mzy410104-lgtm/auto_car/TAXI_TT02_ARCHITECTURE_FINAL_CLEANUP_PROMPT.txt

Precisely clean up the provided engineering diagram. Preserve every box, word, color, font, and all other connections. Make ONLY these two local line corrections. Reference image dimensions are 1672 x 941; coordinates below are approximate guides.

1. In the left panel, REMOVE the entire obsolete blue stub coming out of the TOP of "SHARP GP2Y0A21YK0F ×2": the segment rises from approximately (363,670) to (363,643), then runs right to approximately (430,643). Erase that whole unused L-shaped wire and its tiny upward tail. Keep the existing downward arrow from the BOTTOM of SHARP into "Adaptation des entrées analogiques". Keep the existing blue wire from the RIGHT edge of the adaptation block (approximately 457,762), going right and then UP to the NUCLEO bottom edge at approximately (473,612). Put the label "ADC" beside this retained adaptation-output vertical wire. Final SHARP path must have exactly one chain: sensor -> input adaptation -> STM32, with NO outgoing wire from the TOP of SHARP and no unconnected blue stub.

2. In the right power panel, REMOVE ONLY the redundant OUTER LEFT red wire linking the LEFT edge of "Entrée batterie du TBLE-04S" to the LEFT edge of "BEC du TBLE-04S". It starts around (1154,411), goes left to (1134,411), down to (1134,561) and right to (1148,561). Erase that entire outer-left U-shaped red route and its arrowhead at BEC. KEEP the distinct existing red vertical branch from the RIGHT side of the ESC input block down into the TOP of BEC, around x=1283 from y=436 to y=545. KEEP the separate arrow from ESC input down to "Sortie moteur". Final connection: ESC input block has exactly two outgoing red arrows, one to motor output and one to BEC. There must be no link from motor output to BEC.

Do not redraw anything else. No new wording, boxes, sensors, wires, arrows or power connections. The intended final architecture and remaining labels are already correct. Erase obsolete wires cleanly to the existing white background without blur, artifacts or traces. Retain the full image and its legibility.
