mzy410104-lgtm/auto_car/data/raw/README.md

# Large Raw Data

This directory is reserved for large local files such as lidar recordings and long videos. Git tracks only this README by default. No new recordings have been saved here.

Once actual team-shared storage is in use, record the original filename, acquisition conditions, size, checksum information and accessible location in tests/records. Enter the actual sharing URL and permissions; do not commit access tokens.
