mzy410104-lgtm/auto_car/sources/architecture/ARCHITECTURE_ORIGINAL_2026-09-08.jpg

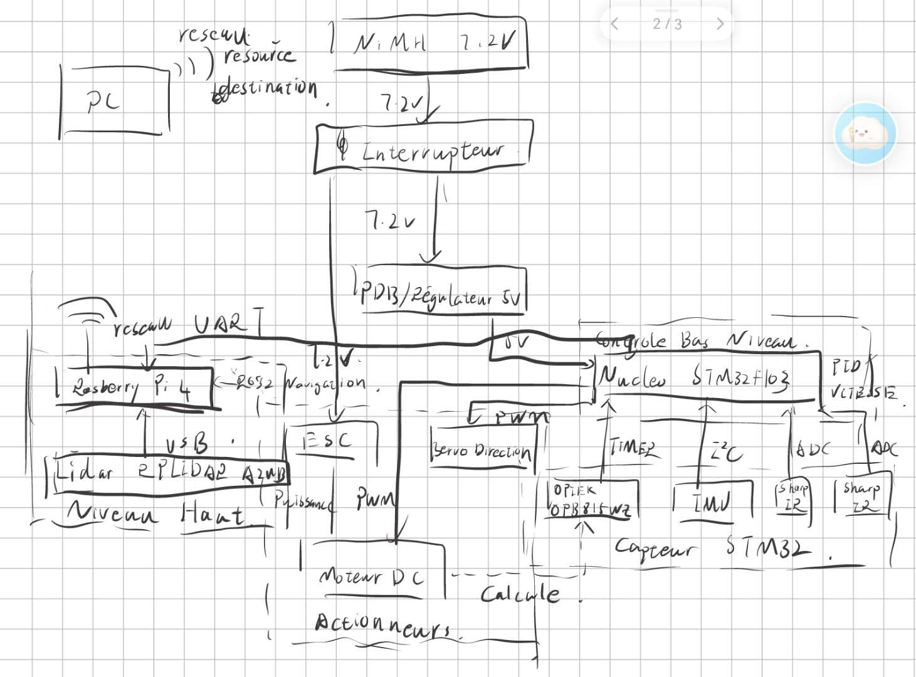
sources/architecture/ARCHITECTURE_ORIGINAL_2026-09-08.jpg
