mzy410104-lgtm/auto_car/TAXI_TT02_ARCHITECTURE_COMPLETED.png

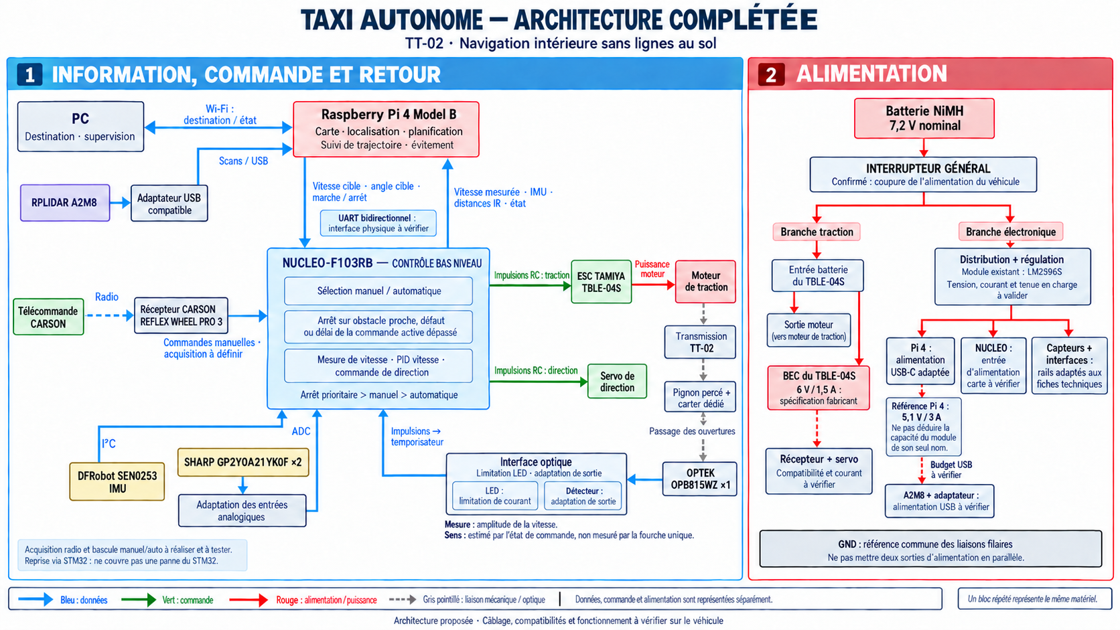
TAXI_TT02_ARCHITECTURE_COMPLETED.png
