mzy410104-lgtm/auto_car/EXISTING_HARDWARE_INVENTORY_EN.md

# Autonomous Taxi: Existing Hardware Inventory

Record date: 2026-09-08. Basis: the user confirmed, “This is the hardware we already have,” and has provided thirteen photographs so far. Figures 1 through 11 show the complete vehicle, components, and labels; Figure 12 is the chassis illustration on the packaging; Figure 13 shows the handheld transmitter. The correspondence between figure numbers and original images is listed at the end. The user separately confirmed that there are 2 SHARP sensors, that the vehicle's ESC is a TAMIYA TBLE-04S, that the Gravity sensor board is a DFRobot SEN0253, and that the adjustable power board is called “Arduino LM2596S.” The user also stated that the propulsion battery brand is PTH08, its chemistry is NiMH, and its nominal voltage is 7.2V. The user previously selected the TT-02; the available photographs do not show the complete chassis kit part number.

This record confirms that items are present and records legible markings. Power-up, communication, sensor outputs, driving, and navigation functions have not yet been checked. Neither historical project documents nor model recommendations from the previous proposal automatically identify the physical items in the photographs.

**Camera-method update (2026-09-22): the user retained the decision not to purchase a stereo camera and adopted visual map-region recognition using an onboard monocular camera.** The camera supplies a validated place or map-region constraint; lidar map matching, wheel-speed feedback and IMU information supply the continuous planar pose. Existing availability, exact camera model, interface, field of view and mounting arrangement have not been provided, so camera ownership and procurement status remain to be checked. Do not record a specific camera as selected until its marking or purchasing decision is available.

**Existing accessories update (2026-09-08): the user confirmed, “We have a bootable SD card, enough data cables, and a handheld transmitter.”** These three items are removed from the list of items whose presence needs confirmation and from default additional purchases. Figure 13 has legible CARSON, REFLEX WHEEL, PRO, and numeral 3 markings; the item is recorded as 1 CARSON REFLEX WHEEL PRO 3 series handheld transmitter. The series name does not establish its complete product number, actual pairing with the receiver, or behavior when the radio link is lost. The system card is recorded as bootable on the basis of the user's confirmation; its capacity, operating system version, and navigation software operating status are not yet verified. Having enough data cables does not establish that the lidar USB adapter or communication functions have been verified.

The packaging illustration in Figure 12 is reference material. Its depicted models and “NOT INCLUDED” labels cannot replace the record of the actual equipment on the current vehicle.

## Assessment of Support for the Project

**Assessment on 2026-09-08: the existing hardware covers the main computing, sensing, and actuation components and can serve as the development basis for an indoor, low-speed navigation prototype without floor markings. It is not yet established that the existing parts alone can reliably meet every objective.** This is an engineering assessment based on the confirmed hardware and manufacturer specifications; functional testing, performance testing, and acceptance of this particular vehicle have not been completed.

| Project function | Existing hardware basis | Work still required |
|---|---|---|
| Mapping and localization on a map | A2M8 and Pi4 for mapping and lidar map matching; monocular camera for validated place/map-region constraints; wheel-speed feedback and SEN0253 for motion information | Camera availability and model; real images with map-region labels; held-out-run visual validation; valid lidar scans; coordinate transforms and stable `(x, y, yaw)` localization; neither the IMU nor one image class directly provides XY coordinates |
| Fixed-pickup request and route planning | Location-specific QR codes and phone web page; Pi4 request service and station-pose configuration | Network path from phone to vehicle; pickup-identifier handling; mapped stopping pose and arrival heading for each pickup point; routes that accommodate vehicle dimensions, steering constraints and actual space |
| Path following | NUCLEO-F103RB, TBLE-04S, existing motor and servo | The user confirmed that the speed-sensing assembly is absent; it must be purchased and mechanically installed, followed by verification of speed feedback, speed and steering calibration, smooth low-speed operation, braking, and reverse behavior |
| Real-time obstacle detection, stopping, and driving around obstacles | A2M8, 2 SHARP distance sensors, Pi4, and STM32 | Actual sensing coverage, end-to-end response latency, stopping distance, space for avoidance maneuvers, and dynamic-obstacle tests; stopping after detection does not establish that driving around obstacles has been implemented |
| Independent onboard operation | Battery, LM2596S module, existing wiring and platforms; the user confirmed a bootable SD card, enough data cables, and a handheld transmitter | Stable power, communication-link tests, mounting and insulation, reliable stopping, and manual takeover; operating duration cannot currently be estimated |

Prioritize four issues that are separate from identifying model numbers:

1. **Motion feedback.** On 2026-09-08, the user explicitly confirmed that the vehicle does not have the speed-sensing assembly just discussed and that they need to purchase it. It is therefore recorded as missing and pending purchase. Add the optical detector, a compatible rotating detection structure, and mounting parts, then establish and verify feedback for actual vehicle speed and motion; the control pulse width is not a measured vehicle speed. The current preferred reference is the CoVAPSy perforated transmission gear and dedicated gear cover. Its single-channel photointerrupter does not automatically satisfy the requirement for forward/reverse direction feedback. This missing assembly does not make every lidar-mapping approach infeasible, but unverified software motion estimation cannot be treated as existing, working feedback.
2. **Power for the complete vehicle.** [Raspberry Pi's official power documentation](https://www.raspberrypi.com/documentation/computers/raspberry-pi.html) recommends a 5.1V/3A supply for Pi4 and gives a combined peripheral-current limit of 1.2A across all USB ports. These are power-design requirements, not a statement that Pi4 always consumes 3A. Whether the existing LM2596S module can support the actual load still needs verification; the chip's 3A rating does not establish that the vehicle's 5V supply is adequate.
3. **Low-speed operation and turning.** The vehicle's servo-steering mechanism requires feasible turning paths; it cannot be planned as a platform capable of turning on the spot. Room dimensions, actual minimum turning space, minimum stable vehicle speed, and stopping distance have not been measured. These determine suitability for the available space. Retain the motor and servo models as unknown; further disassembly to identify them is not required for this assessment.
4. **Obstacle-detection coverage and stopping capability.** [The manufacturer's A2M8 specifications](https://www.slamtec.com/en/lidar/a2spec) list a 0.2–12m range, 360° coverage, and a typical scan frequency of 10Hz. A 2D scanning plane does not establish detection over the full height of the vehicle. The mounting positions and 10–80cm operating range of the 2 SHARP sensors also do not establish coverage of every close, side/rear, or low obstacle. Validate slowing, stopping, driving around obstacles, and waiting when blocked against the final test-space obstacle layout. Also verify behavior after communication loss or a manual stop request.

Retain the Pi4, F103RB, A2M8, SEN0253, chassis, and existing actuators in the purchasing plan; there is currently no evidence supporting replacement of the entire system. The speed-sensing assembly is pending purchase as confirmed by the user, and its mechanical adaptation still needs to be designed. Any additional power, stopping/manual-takeover, or mounting components should be determined from power, basic driving, and sensor-data test results. The user confirmed that system storage, data cables, and a handheld transmitter are available, so their presence no longer needs confirmation. The lidar adapter and actual communication still require verification. The charger model is no longer a confirmation item.

## 1. Items Confirmed by Photographs and User Statements

| Item | Confirmed quantity | Evidence and legible markings | Information not yet confirmed | Purchasing treatment |
|---|---:|---|---|---|
| Vehicle chassis and wheels | 1 set, 4 wheels | Figure 4 shows the complete vehicle; Figure 5 is a close-up; the user previously selected TT-02 | Complete chassis part number; these photographs do not establish 58631 | Inspect and reuse the existing chassis first; do not purchase a duplicate complete chassis |
| Perforated upper mounting platform and supports | 1 set | Figures 1, 2, and 4; the platform is already mounted on the vehicle | Material, actual dimensions, load capacity, and final mounting layout | Use the existing platform first and make local adjustments as required by added equipment |
| RPLIDAR A2M8 lidar | 1 unit | Figures 1 and 4 show the device; the underside label in Figure 11 clearly reads RPLIDAR and A2M8, establishing the model | Hardware revision, USB adapter model, actual power supply, and operating status; the obscured serial number is not transcribed | Design around the existing A2M8; remove the previous default purchase of an A1M8; first check the adapter and test scan data |
| LM2596S adjustable step-down power module | 1 board | Figure 2 confirms the board and adjustment potentiometer, with IN+, IN-, OUT+, and OUT- markings; the user explicitly supplied the name “Arduino LM2596S,” so LM2596S is recorded on that basis | Board manufacturer, complete part number, and chip suffix are not verified; actual input/output voltage, continuous output current, temperature rise, and connected loads have not been tested | Retain the existing module; check wiring and take measurements first; do not treat it as a verified Raspberry Pi supply |
| DFRobot SEN0253 Gravity orientation and barometric sensor board | 1 board | Figure 3 confirms its presence, with Gravity, IIC, and X/Y/Z markings; the user explicitly confirmed DFRobot SEN0253, which the manufacturer's documentation identifies as BNO055 + BMP280 | Board revision, existing wiring, mounting orientation, calibration status, and actual data output are not yet verified | Prioritize reuse of SEN0253 and remove the default BNO085 purchase; design acquisition around the actual BNO055 and BMP280 functions |
| SHARP GP2Y0A21YK0F infrared distance sensor | 2 units (user-confirmed) | Figure 10 clearly reads SHARP and 2Y0A21 F 15; page 2 of the manufacturer's datasheet lists 2Y0A21 F as this model's housing marking; the user subsequently stated, “We have two” | Each sensor's mounting position, wiring harness, and functional status | Include both in existing hardware; measure and calibrate them before deciding how many additional close-range sensors to purchase |
| Optical-module installation at a vehicle end and white bracket | At least 1 installed location | Figure 5 clearly shows the module, connector, and bracket; the component at another corner in Figure 4 is obscured | Figure 10 does not show the mounting position at the same time, so it cannot identify which location in Figure 5 it corresponds to or establish that the other location uses the same model | This row records installation evidence only; do not add it to the preceding row when counting sensors |
| Breadboard, jumper wires, and wiring harnesses | 1 group | Figures 3 and 4 | Exact connections, pins, voltages, and communication network | Inventory and organize them first; photographs do not establish correct wiring |
| Data cables | User confirmed sufficient quantity; USB cables are visible in photographs | Figures 1 and 4 and the user's statement, “Enough data cables” | End-to-end communication with each device and lidar-adapter functionality have not been tested | Do not default to purchasing more data cables; verify actual communication after connection and do not ask again whether the quantity is sufficient |
| Radio-control receiver | 1 unit | Figures 6 and 7; CARSON, REFLEX WHEEL, PRO, numeral 3, CH1 through CH4, F/S Set., B/C, and 2.4g are legible | The Reflex Wheel PRO3 product series is identifiable; complete product number, actual pairing, and failsafe status are not yet verified; the handheld transmitter is confirmed available | Reuse the existing radio-control equipment; later verify pairing, control, and manual-takeover functions |
| Handheld transmitter | 1 unit | The user confirmed possession; Figure 13 clearly reads CARSON REFLEX WHEEL PRO 3 | Complete product number, power status, actual pairing with the existing receiver, and stopping/manual-takeover behavior are not yet verified | Already available; do not default to another transmitter or a FlySky set, and do not ask again whether it is available |
| Raspberry Pi boot SD card | A bootable SD card is available | The user explicitly confirmed, “We have a bootable SD card” | Capacity, operating system version, and navigation software operating status are not yet verified | Record it as bootable on the basis of user confirmation; do not default to buying another card or reflashing the existing system card |
| TAMIYA TBLE-04S ESC | 1 unit | Figures 6 and 7 confirm the physical device; the user read the label and ultimately confirmed the letters TBLE, so TAMIYA TBLE-04S is recorded on that basis | Current motor model, brushed/brushless mode, throttle calibration, reverse settings, actual BEC load, and functional status | Reuse the existing TBLE-04S first and remove the default WP-1060 purchase; check compatibility with the motor, battery, and servo |
| Steering actuator assembly | 1 set | Figures 6 and 7 show the steering linkage, output arm, and connected housing | The user explicitly stated that the servo model cannot currently be identified; record it as unknown; power requirements and functional status are unverified | Retain the existing item; remove the model-identification request and stop asking for the label; do not default to an S-U300 simply because the model is unknown |
| Drive motor | 1 location, partially visible | Figure 7 shows a metal end near the cover on the right | The user explicitly stated that the motor model cannot currently be identified; record it as unknown; brushed/brushless type, compatibility, and functional status are unverified | Retain the existing item; remove the model-identification request and stop asking for its nameplate; do not identify it as the previous proposal's Type540 or default to replacement because the model is unknown |
| PTH08 NiMH propulsion battery pack, nominal 7.2V | 1 pack | Figure 7 confirms the pack, with a large 3000 marking visible on the wrapper; the user confirmed NiMH and 7.2V and explicitly stated, “The brand is PTH08”; the brand field follows the user's wording | Capacity and its unit, and exact model: the user explicitly cannot currently confirm these, so they remain unknown; connector polarity and battery health have not been tested; the brand has not been independently verified | Retain the existing-item record; do not repeat requests for capacity, its unit, or exact model at this stage; assess reuse from subsequent battery-condition evidence rather than immediately buying another due to missing information; stop requesting the charger model as instructed by the user |
| Onboard computer | 1 board | Figure 8 has a clearly legible Raspberry Pi 4 Model B PCB marking; the user confirmed an existing bootable SD card | RAM capacity, hardware revision, operating system version, and navigation workload are unconfirmed; the previous 4GB recommendation cannot be recorded as the actual capacity | Continue with the existing Pi4 and system card; do not purchase a complete KIT-PI4-4 |
| Raspberry Pi lower case and heatsinks | 1 lower case, 4 heatsinks | Figure 8 shows the red lower case and 4 installed heatsinks | Case brand/model, top cover, any separate fan, and actual thermal performance are unconfirmed | Inventory the existing accessories first; do not default to an official case purchase; check compatibility with the existing case before considering an SC0448 fan |
| Low-level controller board | 1 board | Figure 9 clearly reads NUCLEO-F103RB on the label and MB1136 rev C on the PCB | Firmware, programming/debugging, and operating status are unconfirmed; verify the target chip's complete part number against this board's official documentation | Design low-level control around the existing F103RB; do not default to buying a NUCLEO-F446RE |
| Onboard debugger | 1 integrated set on the NUCLEO board | The ST-LINK area is visible in the upper half of Figure 9; the official MB1136 manual states that ST-LINK/V2-1 is integrated | USB connection, debugger firmware, and usability have not been tested | No default purchase of a separate ST-LINK is needed; check the existing USB data cable first |

Do not count the same item more than once across photographs. There are 2 SHARP sensors in total, based on the user's additional confirmation; the individual mounting locations of the two sensors on the vehicle remain unconfirmed.

### Does a Standard TT-02 Include a Vehicle-Speed Encoder?

Tamiya's official website was checked on 2026-09-08 at the user's request. **Based on the drivetrain structure, electronic-equipment connections, and parts list in the general TT-02 assembly manual, a standard TT-02 chassis does not include an encoder for reading vehicle speed or distance traveled.** This conclusion concerns the manufacturer's standard assembly configuration; it does not mean that inspection of the user's modified vehicle has been completed.

The sources are the TT-02 entry in [Tamiya's official manual-download page](https://www.tamiya.com/english/rc/manuals.htm) and its [24-page manufacturer PDF](https://www.tamiya.com/cms/english/rc/rcmanual/tt02.pdf). Every page was viewed, with enlarged checks of motor installation on page 8, radio-equipment connections on page 13, electronic-equipment installation and wheel assembly on page 15, and the parts lists on pages 22–23. These diagrams and lists show no encoder, speed-sensing probe, or corresponding feedback wiring. The PDF consists of scanned pages; the conclusion was not based on an unsuccessful text search.

The original PDF is unmodified and stored at `sources/TT02_TAMIYA_official_manual.pdf` (the manufacturer document is retained locally). This check used general TT-02 documentation; it does not associate the user's chassis with 58631 or another unconfirmed kit part number, nor does the illustrated motor establish the motor model on the current vehicle.

Manufacturer documentation alone cannot establish whether a modified vehicle already has a speed-sensing assembly. After the website check, the user explicitly stated that this vehicle does not have the assembly and that they need to purchase it. The current record is therefore: **the standard factory configuration does not include a vehicle-speed encoder; the user confirmed that the current vehicle also lacks the speed-sensing assembly, which is listed as pending purchase.** This is additional information supplied by the user about the current vehicle; purchasing, installation, and feedback testing have not been completed.

### Speed-Sensing Assembly Confirmed Missing and Requiring Purchase

**Current selected approach: follow the user's explicit choice of the official CoVAPSy perforated transmission gear method.** The configuration comprises 1 perforated transmission gear, 1 matching gear cover for mounting the photointerrupter, and 1 OPTEK OPB815WZ photointerrupter, installed in the gear area beside the motor at the rear end of the central driveshaft. The route of directly sensing the hole in the shaft itself, and requests for additional shaft-hole dimensions, are canceled. The perforated gear and dedicated gear cover are reinstated as mechanical parts that need to be obtained. The previous separate encoder disc/hub, dual-photointerrupter, and Seeed-module approaches are no longer current tasks. This decision concerns the speed-sensing mechanics; it does not mean replacing the vehicle's computing platform or controller board with the models in the website's example.

**Component-selection and space-verification update: use 1 OPTEK OPB815WZ.** The user stated that the Seeed photointerrupter is too short to use directly with the perforated speed-sensing gear and selected OPB815WZ instead. The user subsequently stated, “After checking, only one can be installed.” Based on the user's physical-space verification, the quantity is fixed at 1, and the dual-photointerrupter arrangement and its space-checking tasks are canceled. This record does not mean that the assistant independently measured dimensions, nor does the space check establish purchasing, electrical connection, or successful speed-sensing tests.

**Hole in the current vehicle's shaft:** the user confirmed a transverse through-hole in the shaft itself near the rear of the vehicle, with nothing inside the hole. This fact is retained as a physical observation. The user subsequently chose the official gear method, so this hole is not used in the current speed-sensing approach. Shaft-diameter and hole-diameter measurements or optical-path tests for directly sensing the shaft hole are no longer requested. The hole's original purpose remains unknown; it is not recorded as an official speed-sensing hole.

The implementation sequence is to obtain the perforated transmission gear and matching cover using the official documentation, check the current gear mounting relationship and platform clearance, install 1 OPB815WZ, adapt the circuit to the existing NUCLEO-F103RB, and then verify pulses, effective counts per revolution, the actual transmission ratio, and low-speed behavior. Having documents and selecting an approach do not constitute completed mechanical fabrication, installation, electrical testing, or navigation acceptance; the assistant has not purchased parts or modified the vehicle.

The official mechanical source files and two assembly PDFs have been saved; see the [source and file index](sources/CoVAPSy_encoder_official/SOURCE_INDEX.md). The mechanical files' byte counts and Git blob checksums were verified to match. CAD dimension checking, format conversion, and slicing have not been performed. The original materials can be submitted to the school's workshop for review of the fabrication approach.

This modification is based on **official CoVAPSy project documentation**, not a factory encoder mounting location designated by Tamiya. The [La mécanique section of the CoVAPSy website](https://ajuton-ens.github.io/CourseVoituresAutonomesSaclay/voiture_type/) explicitly describes modifying the gear on the driveshaft and adding a photointerrupter and a new gear cover. The relevant pages of the original kit photographs and assembly guide have been viewed:

| Component or location | Information confirmed by the official documentation |
|---|---|
| Rotating detection structure | On page 2 of `Photos_kit_CoVAPSy_2024.pdf`, item 23 is `Roue dentée percée pour la mesure de vitesse`, a perforated speed-sensing gear; the gear doubles as the encoder disc, so a separate disc does not need to be clamped around the middle of the long shaft |
| Mounting structure | Item 24 on the same page is `Carter impression 3D pour le montage de la fourche optique`, a 3D-printed gear cover for mounting the photointerrupter; a matching replacement cover is required rather than direct installation on the original vehicle |
| Photointerrupter and location | Item 15 on the same page is the speed-sensing photointerrupter; the assembly image under `Fixation de la fourche optique` on page 5 of `Guide_Assemblage_kit_CoVAPSy.pdf` shows it mounted on the transmission gear cover beside the motor, near the rear of the vehicle; the text specifies 2 MB1 or MA2 self-tapping screws from the kit |
| Officially listed component | Both the 2021 and 2026 lists on the CoVAPSy website include **OPTEK TECHNOLOGY OPB815WZ**; compatibility of the previously discussed Seeed 101020587 with this gear cover has not been established |

Original sources: [assembly guide](https://github.com/ajuton-ens/CourseVoituresAutonomesSaclay/blob/main/Hardware/Guide_Assemblage_kit_CoVAPSy.pdf) and [kit photographs and parts list](https://github.com/ajuton-ens/CourseVoituresAutonomesSaclay/blob/main/Hardware/Photos_kit_CoVAPSy_2024.pdf). The [official mechanical-files directory](https://github.com/ajuton-ens/CourseVoituresAutonomesSaclay/tree/main/Hardware/pieces_mecaniques_stp_dxf) provides `Carter pignon support fourche.stp` and `Pignon intermediaire 70dts.dxf`. Dimensional checks between these files and the current gear, cover, and upper platform have not been completed; no unread hole diameters, hole counts, or machining coordinates are specified. Machining/printing can be commissioned using the original files, without requiring the team to have prior 3D-printing experience. Current kit availability and quotations have not been verified.

**Treat speed measurement and direction detection separately.** The [manufacturer's OPB815 datasheet](https://www.ttelectronics.com/TTElectronics/media/ProductFiles/Datasheet/OPB815.pdf) describes one infrared LED and one NPN phototransistor inside the device. OPB815WZ therefore provides single-channel detection and cannot independently provide A/B phase-based direction detection. Its suitability for measuring speed at this mechanical location does not mean that reverse-direction feedback or complete odometry has been solved for the project. The direction of a control command must not be treated as measured direction. Current limiting, output pull-up/signal conditioning, and wiring to the F103RB still require separate checks; the Grove board's wiring cannot simply be reused.

**Suggested implementation with one photointerrupter: measure speed magnitude with the sensor and use verified motion-control states to provide inferred direction.** With a repeated detection structure having identical, evenly spaced openings, a single pulse channel cannot distinguish forward from reverse rotation. [TI's incremental-encoder explanation](https://www.ti.com/document-viewer/lit/html/SBOA200) distinguishes single-channel speed measurement from direction detection using the phase relationship between two channels. The earlier two-OPB815WZ approach has been withdrawn following the user's space verification and is no longer a purchasing or cover-modification task.

| Control phase | Suggested treatment of speed and direction |
|---|---|
| Steady forward drive | Pulses provide speed magnitude; infer a positive sign from the established forward-control state and identify the control state as the source of direction |
| Request to change from forward to reverse or from reverse to forward | Decelerate and carry out the stopping procedure first; receiving a command for the opposite direction must not immediately change the sign of the recorded speed |
| Braking, neutral, startup, and direction-change transitions | Neutral does not establish that the vehicle is stationary, and a new command's direction is not measured direction; retain raw pulses, mark direction as undetermined during transitions, and do not output a trusted zero speed/displacement when direction is unknown |
| After satisfying stopping criteria calibrated on the actual vehicle | Only then execute the direction-change procedure appropriate to the current TBLE-04S; after entering the opposite drive state, infer the speed sign from that state. Specific control pulse widths, sequences, and delays have not been verified and are not assigned values here |
| Use of signed distance traveled | Accumulate it on this basis only in operating phases where direction estimation is applicable; retain the uncertainty in transition data rather than using it as though the sensor had measured direction |

The no-pulse observation period used in the stopping criteria, minimum resolvable speed, and ESC direction-change behavior require calibration on the actual vehicle. A no-pulse timeout is not strict proof of zero speed, and even steady drive does not rule out external pushing, slipping, or an actuator failing to follow its command. Combining one photointerrupter with control-state information can be an implementation approach for a controlled, low-speed prototype; it does not establish independent detection of actual reverse motion or completed navigation acceptance. If that capability is an acceptance requirement, evidence from another independent motion observation is still needed. Only the sensor model and quantity have been selected at this stage; firmware, wiring, and acceptance requirements have not been changed.

**Check of direction handling in the official CoVAPSy example:** the [official `CoVAPSy_US_vitesse_Ecran_G431.zip`](https://github.com/ajuton-ens/CourseVoituresAutonomesSaclay/blob/main/Software/programmes_STM32G431_lectureVitesse/CoVAPSy_US_vitesse_Ecran_G431.zip) has been inspected. In `CoVAPSy_US_vitesse_Ecran_G431/Core/Src/main.c` within the archive, `HAL_TIM_IC_CaptureCallback` calculates `vitesse_mesuree_m_s` on line 281 from a distance coefficient, number of intervals, and total time; it does not assign a negative sign based on a reverse command. `set_vitesse_m_s(float vitesse_m_s)` and `recule(void)` in `Core/Src/CoVAPSy_moteurs.c` handle motor commands without adding direction to that measured value. This conclusion is limited to the inspected example: the speed output is a magnitude, and the existence of a reverse-command function does not establish that the sensor detected reverse motion. The example has not been ported to the user's F103RB or verified on the vehicle.

For the current official gear approach, the mechanical checks concern the large transmission gear, existing gear cover, replacement-cover mounting locations, and platform clearance. Vehicle-speed conversion must use the actual rotational relationship between the measured gear and the wheels. That ratio and the effective counts per revolution have not yet been verified; the total motor-to-wheel reduction ratio cannot simply be substituted, and the free rotation of one wheel through the differential cannot represent straight-line driving. The assistant has not purchased, fabricated, installed, or completed speed tests.

Another mounting location documented by a manufacturer is the rear wheel end used by the [MODECO TT02 rear-wheel encoder](https://modeco-ad.jp/jpn/modecar/modecar-tt02-encoder/). The manufacturer provides a matching toothed ring, optical sensor, and wheel-end bracket, specifying 36 pulses per wheel revolution and A/B phases. However, it limits compatibility to on-road TT02 models and excludes the off-road suspension/wheel-end structures it identifies. Compatibility with the current vehicle's wheel ends has not been verified. Off-road tire tread alone cannot establish compatibility or incompatibility, and the Seeed board cannot be treated as a direct replacement for this kit's sensor. In the current work cycle, the rear gear-cover location with complete CoVAPSy modification documentation is the preferred recommendation.

**The earlier Seeed-module documentation is retained as an electronic-interface reference; it is no longer the default item to order.** The Seeed Grove Optical Rotary Encoder **101020587 / TCUT1600X01** supports two-channel detection. [Seeed's official hardware documentation](https://wiki.seeedstudio.com/Grove-Optical_Rotary_Encoder-TCUT1600X01/) specifies 3.3V/5V power and a 3mm optical slot width. The [GoTronic page](https://www.gotronic.fr/art-module-encodeur-optique-grove-101020587-28244.htm) checked on 2026-09-08 listed €12.20 TTC, product code 35952, with a Grove cable but no encoder disc. This is not a quotation for the CoVAPSy-compatible photointerrupter or a complete speed-sensing assembly. If this board is used for two-channel feedback later, the mounting cover, detection pattern, and operating clearances must be redesigned and verified; a 3mm slot width cannot directly be treated as the encoder-disc thickness.

**Official-website check of central driveshaft dimensions:** Tamiya's [English 54501 product page](https://www.tamiya.com/english/products/54501/index.html) explicitly distinguishes the original resin central shaft C4 from the replacement 54501 aluminum central shaft. A Service Team answer in the FAQ on the [official German 300054501 product page](https://www.tamiya.de/tamiya_en/spare-parts-accessories/rc-tuning-parts/tt-02-aluminium-propeller-shaft-300054501-en.html) gives the aluminum shaft's dimensions as “length 140mm, diameter 5.5mm.” The answer does not define which shaft section the diameter refers to, its tolerance, or the usable clamping length. Therefore, 140mm cannot be treated as clamping length, and 5.5mm cannot be treated as a measured dimension of the unidentified central shaft currently installed on the vehicle.

The general official TT-02 manual was rechecked at drivetrain assembly pages 5–6 and the parts list on page 22, confirming the C4 assembly relationship and C-parts number 51529. These pages do not give the cross-sectional dimensions or clamping length of the relevant central-shaft section. Checks of the English, Japanese, and German 54501 pages and the English 51529 page found no engineering drawing dimensioning each shaft section or CAD download. Clear space and mounting-hole positions around the vehicle's added platform, wiring, and electronics still require measurement. These findings are limited to the documentation checked; the installed shaft has not been confirmed as 54501, and no replacement-shaft purchase was added.

The following interface findings are retained for the Seeed board only: when powered at 3.3V, the Grove-side OUTPUT1/OUTPUT2 in the [complete Seeed schematic](https://files.seeedstudio.com/wiki/Grove-Optical_Rotary_Encoder-TCUT1600X01/res/Grove-Optical_Rotary_Encoder-TCUT1600X01.zip) pass through MOS level conversion and are pulled up to the external VCC; internal OUT1/OUT2 are on the 5V side and must not be confused with them. This conclusion does not apply to the bare OPB815WZ device. The specific F103RB pins, counts per revolution, transmission ratio, and vehicle-speed conversion are still not finalized or verified.

### LM2596S Adjustable Power Module: Model and Role

The user supplied the name **“Arduino LM2596S,”** recorded as 1 existing LM2596S adjustable step-down power module. “Arduino” is retained as the user's original description; it does not establish that the complete board was made by Arduino. No chip suffix or complete board part number is inferred.

[TI's official LM2596 documentation](https://www.ti.com/product/LM2596) describes this family as DC-DC step-down regulators, including adjustable-output versions, and specifies a 3A output-load capability for the chip. This is a chip specification under defined design conditions; it does not establish that this unverified board can continuously deliver 3A, nor does it directly establish its permitted input/output ranges. The board's power capability still depends on external components, cooling, and actual input/load conditions.

The current output voltage, load connections, and ability to power the existing Pi4 and peripherals reliably are not yet verified. First record available input/output voltage and load information, then check voltage, ripple, and temperature rise under load before finalizing the vehicle power arrangement. This update only records the model; the potentiometer has not been adjusted, wiring has not been changed, and electrical testing has not been performed.

### DFRobot SEN0253: Model and Role

The user confirmed that this Gravity board is **1 DFRobot SEN0253**. [DFRobot's official product page](https://www.dfrobot.com/product-1793.html) lists it as Gravity: 10 DOF IMU AHRS BNO055 + BMP280. The model is based on user confirmation, and the chips and specifications are based on manufacturer documentation, not inferred from a historical project configuration.

| Item | Information confirmed by manufacturer documentation |
|---|---|
| BNO055 | Three-axis accelerometer, three-axis gyroscope, and three-axis magnetometer; can output fused orientation data such as quaternions and Euler angles |
| BMP280 | Barometric pressure and temperature measurement; the manufacturer calls its combination with the nine-axis orientation sensor a 10DOF module |
| Module power | 3.3–5V DC |
| Module interface | Gravity-I2C |

The project will prioritize the BNO055's angular-velocity and orientation data to assist vehicle motion estimation. Planar position still needs to be calculated using methods such as lidar-based localization on a map. The BMP280's pressure and temperature readings do not directly provide planar coordinates within the room.

The planned arrangement is acquisition by the existing NUCLEO-F103RB over I²C, followed by transmission to the Raspberry Pi. Specific pins, power, and bus pull-up voltage are not yet selected; the supply range above does not establish compatibility with every wiring arrangement. Secure the sensor board and establish its mounting orientation before verifying communication, calibration, and data while stationary and rotating. Chip and communication specifications are available in the [official DFRobot Wiki](https://wiki.dfrobot.com/sen0253/). No wiring changes, software downloads, or sensor tests were performed during this check.

### TAMIYA TBLE-04S ESC: Model and Compatibility

The vehicle's ESC is recorded as **1 TAMIYA TBLE-04S, with the model confirmed by the user after reading the label**. This conclusion comes from the user's current statement. The TEU-105BK shown on the packaging and models recorded in historical project material are not identification evidence.

- [Tamiya's official product page](https://www.tamiya.de/tamiya_en/spare-parts-accessories/rc-electronics/tamiya-esc-tble-04s-300045069-en.html) and the [official TBLE-04S manual](https://cdn.simba-dickie-group.de/downloads/300045069/300045069_TBLE-04S.pdf) list forward, brake, and reverse functions. The manual specifies a maximum continuous current of 75A, a 6.6–7.2V input supply, and a 6V/1.5A receiver BEC output. These are manufacturer specifications, not measurements of this unit.
- The manufacturer lists compatibility with Tamiya brushed motors of 25T and above, Sport-Tuned motors, and Tamiya sensored brushless motors of 15.5T and above. Neither the ESC name nor its three motor wires directly establish the current motor type. The user stated that the motor model cannot currently be identified; it remains unknown and is no longer requested. Motor compatibility and the ESC's current mode are not yet verified.
- The official product page lists Ni-Cd, Ni-MH, and Tamiya Li-Fe battery packs. The existing battery's PTH08 brand, NiMH chemistry, and nominal 7.2V are recorded from the user's statements. The user explicitly cannot currently confirm the capacity and its unit or the exact model; these fields remain unknown and are removed from the current list of requested information. The wrapper's “3000” is not recorded as 3000mAh and is not used to estimate operating duration or select charging current. The connector and battery health will be checked later.
- The BEC's 6V/1.5A rating concerns receiver-side power. The cited English ITEM 45069 manual warns that digital servos or servos drawing more than 1.5A may damage the ESC. The current servo model remains unconfirmed, so its power arrangement must be checked against the relevant requirements. The previously recommended S-U300 cannot automatically be used with this BEC. Design Raspberry Pi power separately; do not treat this 6V output as a Raspberry Pi 5V supply.
- Current motor mode, throttle endpoints, braking/reverse behavior, and operating status have not been tested. The current settings of this used ESC must not be inferred from the model or factory settings in the manual. No mode changes or wiring modifications are being performed at this stage.

### Information Provided by the Chassis Illustration on the Packaging

The following text is directly legible in Figure 12. It is recorded only as packaging-illustration evidence and does not change the model or quantity records for the ESC, motor, servo, or battery on the current vehicle:

| Illustrated item | Directly legible text | What this establishes |
|---|---|---|
| Illustrated ESC | TEU-105BK; ESC (NOT INCLUDED) | The illustration uses this model and states that an ESC is not included in the depicted kit; the user separately confirmed that the current ESC is TBLE-04S |
| Illustrated motor | ELECTRIC MOTOR; 540タイプモーター | The illustration shows a 540-type motor, without a separate motor part number or evidence that the current vehicle still uses the illustrated motor |
| Illustrated steering servo | STEERING SERVO (NOT INCLUDED) | The packaging indicates that the servo must be supplied separately; it does not identify the current servo model |
| Illustrated propulsion battery | TAMIYA BATTERY PACK (NOT INCLUDED) | The packaging indicates that the battery must be supplied separately; it does not establish the brand, voltage, or capacity of the current battery |
| Receiver case | RECEIVER CASE | This labels the receiver case; it does not establish that a radio receiver is included in the kit |

The vehicle's ESC, steering mechanism, and battery were already visible in earlier photographs of the actual hardware, so “NOT INCLUDED” on the packaging does not mean the user currently lacks these components. Figure 12 does not show a legible complete kit part number; the chassis part number remains unconfirmed.

### RPLIDAR A2M8: Model and Role

The label in Figure 11 confirms that the existing lidar is **1 RPLIDAR A2M8**. This identification is based on the actual device marking provided in this work, not a device with the same name in a historical project. Engraving on the mounting plate, scratches, and reflections obscure the characters on the right of the label; no serial number or inferred hardware revision is recorded.

- The A2M8 column in [SLAMTEC's official A2 specifications](https://www.slamtec.com/en/lidar/a2spec) lists 360° scanning, a 0.2–12m ranging interval, an 8kHz sample rate, a typical rotation frequency of 10Hz (listed range 5–15Hz), 5V system voltage, and 115200bps UART communication. These are manufacturer specifications, not measurements of this unit.
- The planned role is to acquire scans of surrounding obstacles for processing on the Raspberry Pi to support mapping, localization, and obstacle avoidance. The map, current position, and driving route still require software computation. The designed connection path is A2M8 → matching USB adapter → Raspberry Pi 4 Model B.
- The model, connections, and power supply of the existing USB cable and adapter are not yet verified. [SLAMTEC's official FAQ](https://wiki.slamtec.com/display/SD/RPLIDAR%2BFAQ) confirms 115200bps for A2M8 and advises checking the matching adapter and USB power capability. Physical pin-level wiring is not specified before interface verification; the presence of a USB plug alone does not establish an adequate power supply.
- Retain the existing A2M8 and remove the default A1M8 purchase. Verify stable power, rotation, and valid scans before mapping tests. The QC PASS sticker in the photograph is not a current functional acceptance result.

### SHARP Sensors: Model and Role

The `2Y0A21 F` housing marking in Figure 10 matches the marking information on page 2 of [SHARP's official GP2Y0A21YK0F datasheet](https://global.sharp/products/device/lineup/data/pdf/datasheet/gp2y0a21yk_e.pdf), so the complete model is recorded as **GP2Y0A21YK0F**. This conclusion is based on the marking and manufacturer documentation, not the device's appearance or a historical project configuration.

- **Specified measuring range: 10–80cm; recommended supply: 4.5–5.5V; output: analog voltage.** It uses infrared triangulation, and voltage is not linearly proportional to distance. These specifications appear on pages 1, 3, and 5 of the manufacturer manual.
- Acquisition can be planned through the ADC on the existing NUCLEO-F103RB, with the results passed to the Raspberry Pi to assist obstacle avoidance. Before wiring, connector orientation, output-voltage range, and ADC input limits still need checking, along with any required input protection. This record does not assign pins from the photographs or confirm that direct connection is suitable.
- **Distances below 10cm are outside the specified measuring range.** The manufacturer's curve on page 5 reverses direction at close range; do not assume that output voltage always increases as an object gets closer, or treat an unexpectedly low reading as evidence that the path is clear. The vehicle should stop before entering this range, and the actual mounting layout must be checked for coverage of low obstacles.
- The user confirmed possession of 2 sensors of this model; they have not been tested. Verify both sensors' mounting directions and actual performance before deciding whether to add other close-range sensors; their quantity does not make them equivalent to the VL53L1X sensors in the earlier proposal.

The receiver's series name was also checked against [CARSON's official Reflex Wheel PRO3 product information](https://www.carson-modelsport.com/carson_fr/categories/systemes-de-commande-rc/recepteurs-rc-et-accessoires/recepteur-reflex-wheel-pro-3-24-ghz-500501533-fr.html). The page's product number and power specifications do not automatically apply to the photographed device. Its complete product number must still be read before selecting the matching manual. Different versions exist within this series, so the series name alone cannot determine power requirements or transmitter compatibility.

### Suggested Roles for the Confirmed Control Hardware

- **Raspberry Pi 4 Model B:** handle mapping, localization, path planning, the navigation interface, and lidar-data processing. Read the actual memory capacity and system information first, then verify the algorithm workload. These photographs do not establish that the complete navigation system already runs. Pi4 is available with different memory capacities; the 4 in its board name does not mean 4GB. [Official Raspberry Pi product information](https://www.raspberrypi.com/products/raspberry-pi-4-model-b/)
- **NUCLEO-F103RB:** handle servo/ESC control signals, encoder counting, sensor acquisition, and communication timeouts. According to this board's official documentation, the target MCU is STM32F103RBT6, with a 72MHz Cortex-M3, 128KB Flash, 20KB SRAM, and PWM/encoder timers, ADC, SPI, I²C, and USART. These resources support planning for basic low-level control; final pin and timer allocation, program memory use, and runtime timing still require verification. [ST target-chip datasheet](https://www.st.com/resource/en/datasheet/stm32f103rb.pdf), [official ST MB1136 manual](https://www.st.com/resource/en/user_manual/um1724-stm32-nucleo64-boards-mb1136-stmicroelectronics.pdf)
- The upper half of Figure 9 is the ST-LINK debugger area; the lower half contains the application target MCU. Identifying the chip in the upper half does not identify the target MCU that should run the vehicle firmware. MB1136 rev C is the board-revision marking, while NUCLEO-F103RB is the development-board model confirmed here.
- Subsequent circuits and firmware will be based on the existing F103RB. The existing Pi4 and F103RB can form the project's control-hardware basis; upgrading to new boards is not required before work begins.

## 2. Items Whose Availability Is Not Yet Confirmed

Complete inventory evidence is still missing for the following items. Record them as “not yet verified,” not “missing” or “must purchase.” The user confirmed the bootable SD card, sufficient data cables, and handheld transmitter; they have been removed from this section.

- Raspberry Pi desktop supply, actual onboard power cable, and active-cooling accessories. The Pi4 itself, red lower case, heatsinks, NUCLEO-F103RB, and bootable SD card are confirmed available.
- A power bank for the computing system and power-distribution equipment. Physical and specification evidence for the battery charger has not been obtained. The user explicitly requested that its model no longer be checked, so it is not a model-information request, and this does not imply either a missing item or verified compatibility.
- Manual/automatic switching device; the receiver was confirmed present in Figures 6 and 7, and the handheld transmitter was confirmed by the user and Figure 13.
- Propulsion fuse, mechanical master switch, and stopping-control device.

The ESC is confirmed as TAMIYA TBLE-04S, and the user confirmed the battery's PTH08 brand, NiMH chemistry, and nominal 7.2V. The battery's exact model, capacity, and unit cannot currently be confirmed; they remain unknown without preventing continued inventory of other hardware. The user also stated that the drive-motor and steering-servo models cannot currently be identified. Both remain unknown and are removed from requests for additional model information. Forced disassembly to obtain model numbers is unnecessary, and missing information does not justify immediate replacement. The Pi4 and NUCLEO-F103RB board names are confirmed. None of these items has undergone functional measurement yet; presence, model identification, and functional acceptance are recorded separately.

## 3. Updates to the Previous Purchasing Proposal

1. Purchasing now starts with inventory and verification of the existing vehicle, followed by adding confirmed missing items.
2. Physical evidence exists for the chassis, lidar, mounting platform, receiver, propulsion battery, motor controller, steering assembly, Pi4, and NUCLEO-F103RB; these are no longer default new purchases.
3. Figure 11 confirmed 1 RPLIDAR A2M8. The SHARP modules are recorded as 2 GP2Y0A21YK0F sensors, with quantity confirmed by the user. The user confirmed the Gravity board as 1 DFRobot SEN0253, removing the default BNO085 purchase. The adjustable power board is recorded as 1 LM2596S module on the basis of user confirmation. Next, check interfaces and mounting positions and test the existing items; do not repeat requests for model labels already received or quantities already confirmed.
4. The planned default purchases of KIT-PI4-4 and NUCLEO-F446RE are canceled; design around the existing Pi4 and F103RB instead. A separate ST-LINK is not a default purchase. Use the confirmed TBLE-04S for compatibility checks and cancel the default WP-1060 purchase. S-U300, FlySky, and similar items remain configuration references only; motor type and the ESC's current mode still require checking. The user confirmed the existing CARSON handheld transmitter, bootable SD card, and sufficient data cables, so do not continue searching for them or default to additional purchases. Radio pairing and manual takeover still need testing.
5. The previous €779.33 was a price subtotal for some components proposed as new purchases. No complete budget for additional purchases has been produced in the current work cycle, and the price of a new item cannot simply be deducted on the basis of appearance and reported as confirmed savings.
6. The user ultimately selected the official CoVAPSy perforated transmission gear method. Obtain 1 perforated gear, 1 dedicated gear cover, 1 OPB815WZ photointerrupter, and matching mounting/interface parts. Cancel direct shaft-hole sensing and its measurement tasks; do not continue the dual-photointerrupter, 101020587, or separate encoder disc/hub approaches. One photointerrupter provides speed magnitude; direction derived from control state is inferred direction. Complete assembly, wiring, and motion testing have not been performed, and the assistant has not made purchases.

## 4. Assembly Condition Visible in the Photographs

- Figure 2 shows exposed areas at the power board's solder joints and wire ends, including bare copper at OUT+; insulation and cable securing need to be completed.
- Figure 3 shows exposed male Dupont pins. Figure 4 shows multiple loose wiring harnesses and cables extending beyond the vehicle. Check steering and suspension travel when organizing them.
- Figure 3 does not show screws securing the Gravity board to the vehicle through its two large mounting holes. It is now confirmed as the SEN0253 used for orientation measurement; secure the board and establish its mounting orientation before calibration.
- The current photographs do not establish correct polarity, common grounding, regulated output, or complete vehicle wiring. Power-up checks should follow wiring confirmation, insulation, and mounting.
- No plugs are visible on the receiver's exposed channel headers in Figures 6 and 7. Having a receiver does not establish that radio-control wiring is currently complete. The F/S Set. marking also does not establish that failsafe protection has been correctly configured or successfully tested.

These are installation issues actually visible in the photographs. Power overload, damaged hardware, or normally functioning modules have not been inferred from appearance.

## 5. Minimum Additional Information Needed Next

Record the following three groups of information during subsequent debugging; do not ask again whether the system card, data cables, or handheld transmitter are available:

1. The lidar USB adapter's model and interfaces. The user confirmed the Gravity board as DFRobot SEN0253, so its product number does not need to be supplied again. The A2M8 lidar model and SHARP model and quantity of 2 are also confirmed. Subsequently record the SEN0253 mounting orientation and each SHARP sensor's mounting position.
2. The user confirmed the power board name “Arduino LM2596S”; the same model information does not need to be supplied again. If measurement records already exist, provide input and output voltages and the currently connected loads; leave these fields blank if they have not been measured.
3. An overview beneath the mounting platform and photographs of the Raspberry Pi and STM32 controller boards have been received. The user also confirmed the TBLE-04S ESC model and the battery's PTH08 brand, NiMH chemistry, and nominal 7.2V; these do not need to be provided again. Figure 13 and user confirmation establish that the CARSON handheld transmitter is available; do not ask again whether it is on hand. Subsequently record actual tests of pairing, radio-controlled driving, manual takeover, and stopping on link loss. The user explicitly stated that the charger model does not need confirmation; it has been removed from outstanding information requests and must not be requested again. The user stated that the motor and servo models and the battery's exact model, capacity, and unit cannot currently be confirmed. They remain unknown and are removed from requests for additional model information; add them later if new evidence is volunteered.

Figure 12, the chassis illustration on the packaging, has been received. The current ESC model is confirmed, while the motor and servo models remain unknown; component labels are no longer requested. If the chassis packaging's ITEM number or corresponding purchase record becomes available later, add the complete kit part number then.

The Pi4's actual RAM capacity can be read from system information after the existing system boots normally; there is no need to remove installed heatsinks to identify capacity. The user confirmed a bootable SD card, so do not ask again whether one is available. Power equipment and complete-vehicle stability under load still require verification. Reflashing the card or overwriting existing programs has not been requested.

Also record which actual tests have already been performed on the existing equipment, such as whether the lidar returns scans or whether the vehicle has previously been driven by radio control. Historical tests must identify who performed them and when; do not record “working normally” without test records.

## 6. Original Photograph Index

- Figure 1: 530a8e5f50559f3c014e614785bb861c.jpg (original stored locally, not published with the repository)
- Figure 2: 26a672ce8d8a097b594ae5d48ef5b628.jpg (original stored locally, not published with the repository)
- Figure 3: c50390d66363615e5d6f782ca9e946e9.jpg (original stored locally, not published with the repository)
- Figure 4: 900604fbd960907052ca09acd5ff1acc.jpg (original stored locally, not published with the repository)
- Figure 5: 51a3aa56a92b3fce8fc1a0cf5dff7b80.jpg (original stored locally, not published with the repository)
- Figure 6 (second batch, image 1): ce49ddaa3a132710860846a938c044da.jpg (original stored locally, not published with the repository)
- Figure 7 (second batch, image 2): 1d9abb2aa313f48a6ae989b1a5a17ea2.jpg (original stored locally, not published with the repository)
- Figure 8 (third batch, image 1): 8e490ae034961c29f63987e2702bd05d.jpg (original stored locally, not published with the repository)
- Figure 9 (third batch, image 2): 9f2a1b9bc7e1700bb563797d71ec4db0.jpg (original stored locally, not published with the repository)
- Figure 10 (fourth batch, image 1): 3e6d62b905e955d5e7d4e775c2123b27.jpg (original stored locally, not published with the repository)
- Figure 11 (fifth batch, image 1): b87d83be66c5db92eb403629460b5394.jpg (original stored locally, not published with the repository)
- Figure 12 (sixth batch, image 1, chassis illustration on packaging): 4b74dbd9830d79090c641e92aff5774c.jpg (original stored locally, not published with the repository)
- Figure 13 (seventh batch, image 1, CARSON handheld transmitter): 022b167c0bef76477bb705dfba684f59.jpg (original stored locally, not published with the repository)

The originals are in the WeChat temporary directory supplied by the user. The images were not modified or copied separately during this work. Links may stop working after that directory is cleaned.
