mzy410104-lgtm/auto_car/TAXI_TT02_HARDWARE_BOM_EN.md

# Autonomous Taxi: TT-02 Hardware List and Update on Existing Equipment

## Current Purchasing Basis: Reuse the Existing Vehicle First

By 2026-09-08, the user had supplied thirteen photographs: the first eleven show the existing hardware and its labels, the twelfth shows the chassis illustration on the packaging, and the thirteenth shows the CARSON REFLEX WHEEL PRO 3 handheld transmitter. The [existing hardware inventory](EXISTING_HARDWARE_INVENTORY_EN.md) is the current basis for additional purchases.

**Purchasing decision on 2026-09-08: the user explicitly decided not to buy a stereo camera at this stage.** The current approach uses 2D lidar navigation; a stereo camera is excluded from purchases for the current work cycle. The items still confirmed as required are 1 OPB815WZ, 1 perforated transmission gear, 1 matching gear cover, and any interface-circuit parts and fasteners needed after checking existing materials. The user has confirmed a bootable SD card, enough data cables, and a handheld transmitter. These three items are recorded as available; their existence will not be queried again, and additional purchases will not be assumed. Power-supply and distribution/protection accessories remain under inventory review. Communication, stopping, and manual takeover still require testing; an item that has not yet been verified is not automatically missing.

Current feasibility assessment: the existing hardware provides a development foundation for a low-speed indoor 2D navigation prototype and covers the main computing, sensing, and actuation components. No whole-vehicle test has yet demonstrated that all objectives can be met or that no additional parts are needed. The user has confirmed that the vehicle lacks the speed-sensing components and that the team must purchase them. The immediate priorities are selecting and mechanically adapting those components, then verifying motion feedback, the 5V supply under load, low-speed and turning behavior, and obstacle-triggered stopping. Other items that have not yet been verified are not automatically recorded as missing. Unknown motor and servo models are not grounds for replacing them by default; the charger model will not be queried again. See “Assessment of Support for the Project” in the existing hardware inventory for the detailed assessment.

Additional official-source check on 2026-09-08: the drivetrain assembly, electronic equipment wiring, and parts list on pages 22–23 of the [Tamiya TT-02 general assembly manual](https://www.tamiya.com/cms/english/rc/rcmanual/tt02.pdf) do not include a vehicle-speed encoder. The standard TT-02 does not include this sensor. The user subsequently confirmed that the actual vehicle also lacks this component, so it is recorded as missing and to be purchased; it has not yet been purchased or installed. The motor and gear ratio shown in the general manual are not treated as parameters of the actual vehicle.

| Item | Current status | Purchasing action |
|---|---|---|
| Chassis, four wheels, and drilled mounting platform | Present in the photographs; identification as TT-02 comes from the user's earlier statement; part number 58631 is not confirmed | Inspect for reuse first; cancel the default purchase of a complete new set |
| RPLIDAR A2M8 lidar | 1 available; the underside label in photograph 11 confirms A2M8; the USB adapter, actual power supply, and operating condition are not yet verified | Use the existing A2M8 and cancel the default A1M8 purchase; check the adapter and test scan data first |
| DFRobot SEN0253 Gravity orientation and barometric sensor board | 1 available, with the model confirmed by the user; the manufacturer's specification identifies BNO055＋BMP280, a 3.3–5V supply, and a Gravity-I2C interface; operation and calibration have not been tested | Prioritize reuse of SEN0253 and cancel the default BNO085 purchase; base acquisition design on BNO055 and BMP280 |
| LM2596S adjustable buck-converter module | 1 available; the user called it “Arduino LM2596S,” and the model is recorded from that confirmation; the board manufacturer, actual input/output voltages, continuous current capability, and connected loads are not yet verified | Retain the existing module and check/test its supply first; it is not yet established whether it can reliably power Pi4 and its peripherals, or whether an additional power bank is needed |
| SHARP GP2Y0A21YK0F infrared distance sensor | 2 available, with quantity confirmed by the user; the marking in photograph 10 and the manufacturer's documentation confirm the model; 10–80cm, 4.5–5.5V supply, analog voltage output; the individual mounting positions are not yet verified | Reuse and test these 2 first, then decide on additional purchases from measured coverage; distances below 10cm are outside the specified range, and the quantity does not make them direct replacements for the VL53L1X sensors in the earlier table |
| CARSON radio receiver | 1 available; Reflex Wheel PRO3 series and CH1 through CH4 are identifiable on the front; the full article number is not yet verified; the user has confirmed a separate handheld transmitter, but pairing has not been tested | Reuse the existing radio equipment; do not default to purchasing a FlySky set; subsequently verify pairing, control, and stopping on radio loss |
| CARSON REFLEX WHEEL PRO 3 handheld transmitter | 1 available, confirmed by the user; the brand and series are readable in photograph 13; pairing with the existing receiver, manual takeover, and stopping on radio loss have not been tested | Remove from the list of items whose existence requires confirmation; do not buy another transmitter; design and verify the control chain around the existing equipment |
| TAMIYA TBLE-04S ESC | 1 available; the user read and confirmed the model from its label; the current motor mode and operating condition have not been tested | Prioritize reuse of TBLE-04S and cancel the default WP-1060 purchase; check compatibility with the motor, battery, and servo |
| Steering mechanism and drive motor | The corresponding equipment or parts of it are visible; the user explicitly stated that neither model can currently be confirmed, so both remain unknown; motor type and functional condition are not yet verified | Remove the requests for model information and do not ask for labels again; retain the existing parts rather than purchasing S-U300 or a replacement motor solely because the models are unknown; the TBLE-04S name alone does not establish that the actual motor is brushless |
| PTH08 NiMH traction battery, nominally 7.2V | 1 pack available; brand PTH08, chemistry, and nominal voltage are recorded from the user's statement; the user currently cannot confirm the capacity and its unit or the exact model, which remain unknown; battery health has not been tested | Do not repeatedly request the unknown parameters or buy another battery merely because information is missing; assess reuse from evidence of battery condition, leave runtime estimates blank for now, and do not query the charger model again, as requested by the user |
| Raspberry Pi 4 Model B | 1 available, confirmed by board markings; actual RAM capacity is not yet verified; the user confirms that the SD card boots, but operation of the whole-vehicle software has not been tested | Cancel the default KIT-PI4-4 purchase and use the existing Pi4 first |
| System SD card | The user confirms an existing bootable SD card; capacity and operating-system version are not recorded; the assistant has not independently observed startup | Remove from the list of items whose existence requires confirmation; reuse the existing SD card without defaulting to another purchase |
| Data cables | The user confirms that the available data cables are sufficient; actual connections and communication have not been tested | Remove from the list of items whose existence requires confirmation; do not default to buying more cables; this does not establish that the lidar USB adapter is present or that communication has passed |
| Raspberry Pi lower case and heatsinks | A red lower case and 4 heatsinks are visible; the case model is not confirmed | Check the existing combination first; the fan model must match the existing case |
| NUCLEO-F103RB | 1 available, confirmed by its label; the PCB is MB1136 rev C and includes an onboard ST-LINK section | Cancel the default purchases of NUCLEO-F446RE and a separate ST-LINK; design low-level control around the existing F103RB |
| Stereo camera | The user explicitly decided not to purchase one at this stage | Exclude from purchases for the current work cycle; reassess later against the formal task and actual obstacle coverage |
| Single-channel speed-sensing components | The user explicitly selected the official CoVAPSy perforated transmission gear method, using a total of 1 OPTEK OPB815WZ photointerrupter | Prepare the perforated gear, dedicated gear cover, 1 photointerrupter, and interface/fastening parts; cancel direct sensing of the shaft hole, the two-photointerrupter modification, and the Seeed approach. Direction remains inferred; installation and operation are not yet verified |
| Power accessories and protective devices | The photographs in this work cycle do not provide complete evidence | Record as not yet verified rather than missing; do not include the confirmed SD card, data cables, or handheld transmitter in this category |
| Battery charger | No physical or specification evidence is available; the user explicitly stated that its model need not be confirmed | Remove from the list of models requiring confirmation and do not ask again; this does not establish that it is missing, that another purchase is needed, or that compatibility has been verified |

The packaging illustration labels the ESC as TEU-105BK and the motor as a 540 type; the ESC, servo, and battery are marked NOT INCLUDED. This information describes only the packaging illustration, not the actual vehicle configuration. The user separately confirmed the actual ESC as TBLE-04S. Battery brand PTH08, NiMH chemistry, and nominal 7.2V are recorded from the user's statement. The user currently cannot confirm the motor and servo models, or the battery's exact model, capacity, and unit; these remain unknown and the requests for further information have been removed. Do not infer capacity or charging parameters from the “3000” visible in the photograph, or replace the motor or servo solely because their models are unknown.

The user originally called the power board “Arduino LM2596S.” This does not identify Arduino as the board manufacturer, and no chip suffix is added. The buck-conversion function and 3A rating in [TI's manufacturer documentation](https://www.ti.com/product/LM2596) apply to the LM2596 chip family, not directly to this complete module's continuous output capability. The existing module's voltage setting, voltage under load, ripple, and temperature rise have not been tested; the vehicle's 5V power-supply design is not yet finalized.

The existing TBLE-04S was checked against [Tamiya's official product information](https://www.tamiya.de/tamiya_en/spare-parts-accessories/rc-electronics/tamiya-esc-tble-04s-300045069-en.html) and the [official manual](https://cdn.simba-dickie-group.de/downloads/300045069/300045069_TBLE-04S.pdf): the manufacturer specifies a maximum continuous current of 75A, a 6.6–7.2V input supply, and a 6V/1.5A BEC output. It supports the brushed and sensored brushless motors specified by the manufacturer; compatibility with the actual motor, battery, and servo, and the current ESC settings, are not yet verified. The 6V BEC output is not used directly as the Raspberry Pi's 5V supply.

The English manual for ITEM 45069 cited above warns that digital servos, or servos drawing more than 1.5A, may damage the ESC. The actual servo model is not confirmed; the earlier S-U300 proposal must not simply be reused as a TBLE-04S BEC supply arrangement. The supply must later be checked or redesigned against the actual servo and manufacturer requirements.

The current control design uses the existing **Raspberry Pi 4 Model B＋NUCLEO-F103RB**: the Raspberry Pi handles mapping and navigation computation, while F103RB handles actuation control and sensor acquisition. The Pi4's actual RAM capacity, final F103RB interface allocation, and whole-vehicle operating load still need checking.

Orientation measurement uses the existing **DFRobot SEN0253**. The [manufacturer's product page](https://www.dfrobot.com/product-1793.html) confirms an integrated BNO055 nine-axis orientation sensor and BMP280 pressure/temperature sensor, a 3.3–5V module supply, and a Gravity-I2C interface. The plan is for F103RB to acquire angular velocity and orientation data and send them to the Raspberry Pi; wiring, mounting, calibration, and data quality still require verification. The BNO085 in the historical proposal below is no longer a default purchase.

The lidar configuration uses the existing **RPLIDAR A2M8**. [SLAMTEC's official specifications](https://www.slamtec.com/en/lidar/a2spec) list 360° scanning, a 0.2–12m measurement range, 8kHz sampling, a 5V supply, and UART at 115200bps. These are manufacturer specifications, not measurements from this unit. Connection to the Raspberry Pi is planned through a compatible USB adapter; the adapter and supply still need checking.

The SHARP model and parameters were checked against the [manufacturer's GP2Y0A21YK0F datasheet](https://global.sharp/products/device/lineup/data/pdf/datasheet/gp2y0a21yk_e.pdf). The plan is to acquire its analog output through the F103RB ADC. Detailed wiring, input protection, distance calibration, and stopping distance still require design and measurement. The photographs do not demonstrate that the sensors operate correctly or that every optical module on the vehicle is this model.

### Confirmed Items to Purchase: Speed-Sensing Components

**Design selected by the user on 2026-09-08: the official CoVAPSy perforated transmission gear method.** Following the [official mechanical description](https://ajuton-ens.github.io/CourseVoituresAutonomesSaclay/voiture_type/), a perforated transmission gear also serves as the encoder disc, and the photointerrupter mounts on the matching replacement gear cover. The perforated gear and dedicated gear cover are reinstated as required mechanical parts; direct reading of a hole in the shaft itself and the associated dimensional-measurement tasks are cancelled. This choice concerns only the speed-sensor mounting. It does not mean that Tamiya provided a factory speed-sensing interface, and it does not require replacing the existing Pi4 or NUCLEO-F103RB.

The official original mechanical files and two assembly PDFs have been archived in the [source and file index](sources/CoVAPSy_encoder_official/SOURCE_INDEX.md). Download integrity was checked for the STP and DXF files, which remain unchanged. CAD dimensions, tolerances, materials, and manufacturing methods have not yet been verified. The mechanical directory checked contains no STL file; downloading the STP must not be described as completed preparation for printing.

The user further stated that the Seeed photointerrupter is too short to fit directly with the perforated speed-sensing gear, explicitly selected **OPTEK OPB815WZ**, and reported that “testing confirmed that only one can be installed.” The configuration is therefore fixed at **1 OPB815WZ**, and the two-photointerrupter modification and its space checks are cancelled. The space limitation is based on the user's verification record; purchasing, wiring, and speed-sensing operation have not yet been confirmed.

The user confirmed that the hole passes transversely through the shaft and is clear inside; this remains a record of the physical part. The selected official design reads the holes in the gear rather than this shaft hole, whose dimensions no longer need to be measured. This observation does not demonstrate that the vehicle already has the official perforated gear, and the hole's original purpose is not inferred.

| Item | Corresponding part in the official references | Current purchasing scope |
|---|---|---|
| Perforated speed-sensing gear | Item 23 on page 2 of the official kit document `Photos_kit_CoVAPSy_2024.pdf`; mechanical file `Pignon intermediaire 70dts.dxf` | **1 required**: obtain the official matching part or manufacture it from the official drawing after verification; separate availability and pricing are not yet confirmed, and the filename does not replace verification of manufacturing dimensions |
| Gear cover for photointerrupter mounting | Item 24 on the same page of the official kit document; mechanical file `Carter pignon support fourche.stp` | **1 required**: obtain the official matching cover or have a machining/printing service produce it from the official model; check the actual mounting positions and platform clearance; no quotation is confirmed |
| Photointerrupter | **OPTEK OPB815WZ**, matching the CoVAPSy parts list | **1 unit**; the user verified the space limitation; used to measure speed magnitude, with inferred direction based on control state; no further two-photointerrupter modification is planned |
| Fasteners | Page 5 of the official assembly manual uses 2 MB1 or MA2 self-tapping screws to secure the photointerrupter | Check existing screws against the matching cover and manual; do not assume that the user already has enough hardware or specify an unverified thread |
| Circuit and cables | LED current limiting, detector-side pull-up/load circuitry, and connection design between OPB815WZ and the existing NUCLEO-F103RB | Prepare the required resistors and connection materials; determine resistance values from the supply and operating conditions. Decide on filtering/signal conditioning from waveform tests and reuse existing materials first. This is not a Grove-module connection; pins and prices are not yet determined |

**French purchasing channels, checked on 2026-09-08:** the model to purchase is `OPB815WZ`, quantity 1; do not substitute `OPB815L` or another suffix. The prices below cover only the photointerrupter component, not the CoVAPSy perforated gear, dedicated gear cover, or interface circuit. This was a lookup only; no login, cart addition, or order was performed.

| Channel | Exact ordering information | Price and stock evidence |
|---|---|---|
| [RS France professional site](https://fr.rs-online.com/web/p/capteurs-optiques-a-fourche/1944030) | Manufacturer model `OPB815WZ`; RS stock number `194-4030`; sold as 1 unit | Directly reading the page showed €5.35 HT and **€6.42 TTC per unit**, excluding delivery/handling charges; it showed stock available. Quantity and delivery dates can change; confirm at checkout |
| [Farnell France](https://fr.farnell.com/tt-electronics-optek-technology/opb815wz/optocommutateur-faisceau-trav/dp/1497919) | Manufacturer model `OPB815WZ`; order number `1497919`; the official-site search content showed a minimum quantity of 1 and an order multiple of 1 | The official-site search snapshot showed **€4.540 HT per unit**, with no TTC price; direct access timed out/was denied, so this cannot be recorded as a live price or live stock confirmation |

Individuals purchasing for themselves can use [RS Particuliers](https://www.rs-particuliers.com/), enter the exact model `OPB815WZ` in the search field, and check the manufacturer's model and quantity on the product page. RS separates its professional and private-customer sites. The private-customer home page was opened during this check, but no product-page price or stock result was obtained there for this component; the professional-site quotation cannot simply be applied to it. The [RS private-customer terms of sale](https://fr.rs-online.com/web/content/a-propos-rs/sommaire/conditions-generales-vente-particuliers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) specify €10.20 TTC in handling and delivery charges for orders not exceeding €60 TTC; verify the final amount at checkout.

If the school purchases through a professional account, RS [delivery help](https://fr.rs-online.com/web/content/accueil/aide/options-livraison?intcmp=FR-WEB-_-CP-C3-MCC-0901-Livraison) lists a €9.50 HT handling charge for online orders below €50 HT. Farnell [delivery help](https://fr.farnell.com/help/delivery-information) lists an €11.99 HT handling charge for standard-delivery orders below €75 HT, while the retrieved product snapshot showed a €50 threshold for free standard delivery. These statements conflict, so the final cost of a single-unit Farnell order is not guaranteed. The school's existing account contract prices, discounts, and delivery eligibility were not checked; compare totals at checkout. The complete speed-sensing assembly budget and the vehicle's additional-purchase budget remain undetermined.

Original sources: [assembly manual, page 5](https://github.com/ajuton-ens/CourseVoituresAutonomesSaclay/blob/main/Hardware/Guide_Assemblage_kit_CoVAPSy.pdf), [kit photographs, page 2](https://github.com/ajuton-ens/CourseVoituresAutonomesSaclay/blob/main/Hardware/Photos_kit_CoVAPSy_2024.pdf), and [mechanical files directory](https://github.com/ajuton-ens/CourseVoituresAutonomesSaclay/tree/main/Hardware/pieces_mecaniques_stp_dxf). The corresponding assembly illustrations in both PDFs were reviewed; no mechanical trial fit or electrical test on the actual vehicle has been completed.

**The model and quantity are fixed; operation still requires verification.** The [manufacturer's OPB815 manual](https://www.ttelectronics.com/TTElectronics/media/ProductFiles/Datasheet/OPB815.pdf) specifies a single infrared LED and an NPN phototransistor. With 1 unit, pulse measurements provide speed magnitude, while the sign comes from inferred direction based on motion-control state. Commanded direction is not measured direction. Subsequent vehicle-speed conversion must use the actual rotational relationship between the sensed gear and the wheels; the transmission ratio and effective counts per revolution still need verification.

A stop-before-reversing control sequence is recommended. Receiving a reverse command must not immediately change the measured speed to a negative value. Mark direction as undetermined during braking, neutral, starting, and reversal transitions, and retain the raw pulses; unknown direction must not be treated as reliable zero speed. The stop-observation interval, minimum resolvable speed, and TBLE-04S reversal behavior require calibration on the actual vehicle; no unverified thresholds or delays are specified. A single photointerrupter cannot distinguish coasting or external pushing that disagrees with the control state. This design alone therefore cannot establish independent reverse-motion detection or successful navigation acceptance. The earlier two-photointerrupter mounting proposal based on [TI's two-phase principle](https://www.ti.com/document-viewer/lit/html/SBOA200) has been withdrawn following the user's verification; that principle no longer creates a current hardware task. See the existing hardware inventory for the full proposed state handling.

The previously recommended **Seeed Grove Optical Rotary Encoder 101020587 / TCUT1600X01** is retained only as a reference for a dual-channel electronic module; **the current default recommendation to order it is cancelled**. Its 3mm optical slot and board mounting arrangement have not been shown to fit the CoVAPSy gear cover; using it would require a new mechanical adaptation. The findings on a 3.3V supply and Grove output from the [Seeed hardware description](https://wiki.seeedstudio.com/Grove-Optical_Rotary_Encoder-TCUT1600X01/) and [complete schematic](https://files.seeedstudio.com/wiki/Grove-Optical_Rotary_Encoder-TCUT1600X01/res/Grove-Optical_Rotary_Encoder-TCUT1600X01.zip) apply only to that module, not to OPB815WZ. The earlier GoTronic price of €12.20 TTC was solely for the Seeed module, not a quotation for the new mechanical design.

The official information stating a 140mm length and 5.5mm diameter for central shaft 54501 remains in the [existing hardware inventory](EXISTING_HARDWARE_INVENTORY_EN.md). These are not treated as dimensions of the actual vehicle or as purchasing dimensions for the current gear design. Next, check the actual mounting relationship against the official gear and cover files, prepare the mechanical parts and 1 OPB815WZ, and then complete the F103RB interface design and pulse/low-speed tests. Actual counts per revolution, the transmission ratio, and ESC reversal behavior still require verification; adopting the official mechanical arrangement does not mean speed sensing or navigation has passed. The assistant has not purchased, drilled, machined, or installed anything. The complete speed-sensing assembly cost and the vehicle's total additional-purchase cost remain undetermined.

The earlier all-new purchasing proposal and its sources are retained below for reference once the exact missing items have been identified. Its model tables, connection diagram, and €779.33 subtotal do not represent the actual vehicle configuration or the current additional-purchase budget. The historical request for further motor-nameplate information no longer applies to the current inventory; the user's statement that the models are unknown governs the current status.
---

Review date: 2026-09-08. Project scope: three people, approximately twelve weeks, ten hours per person per week, purchasing in France; indoor operation without floor markings, using a map for localization, destination selection, path planning, path following, and obstacle avoidance.

The following is the reference configuration for an all-new purchase, prepared before photographs of the existing equipment were supplied. The listed product models, public specifications, and sources were checked; no vehicle installation, load, runtime, or navigation acceptance tests were performed. The room dimensions and formal course task brief are not yet established.

## 1. Main Hardware

Prices in the table are the public prices shown on French sales pages during this check, in euros, excluding shipping, promotion codes, and quantity discounts. A blank or unverified price does not mean zero cost. Supplier and manufacturer identifiers are kept separately as given by their sources.

| Component | Selected model | Quantity | Verified unit price € | Purpose and compatibility notes | Source |
|---|---|---:|---:|---|---|
| Chassis kit | **Tamiya 58631 / TT-02** | 1 | 119.80 | Includes chassis, wheels, drivetrain, steering mechanism, body shell, and supplied motor; assembly is required. | [Product page](https://www.jjmstore.fr/tamiya-subaru-impreza-tt02-voiture-rc-kit-58631.html) |
| Drive motor | **Type 540 Motor supplied in the 58631 kit** | 1 | Included in kit | Supplied with the kit; the manufacturer does not publish a separate motor part number, so it is not identified as another specific motor model. | [Product page](https://www.tamiya.com/english/products/58631/index.html) |
| Brushed ESC | **Hobbywing QuicRun WP-1060, Tamiya connector version; Tecnimodel VAHW30120201** | 1 | 37.95 | This version specifies a separate ESC; the ESC supplied free by the kit retailer is not the main ESC for this proposal. | [Product page](https://www.tecnimodel.com/variateurscontroleurs/10032-variateur-hobbywing-1060-quicrun-compatible-lipo-2s-et-3s-avec-prise-tamiya.html) |
| Steering servo | **Futaba S-U300 / 01006009** | 1 | 16.95 | Standard servo; 4.8–6V, 25T spline; use the Futaba-compatible servo horn parts specified in the TT-02 manual. | [Product page](https://www.tecnimodel.com/servos-futaba/15745-servo-futaba-s-u300-numerique-41kg6v.html) |
| Traction battery | **Carson 500608224, 7.2V 3000mAh NiMH, Tamiya connector** | 2 | 28.49 | Install one at a time; the other is a spare for rotation. | [Product page](https://www.carson-modelsport.com/carson_fr/categories/batteries-et-piles-rc/batterie-nimh/72v3000mah-nimh-race-batterie-tam-500608224-fr.html) |
| Traction-battery charger | **Carson 500606099 Expert Charger NiMH 2A** | 1 | 22.99 | 4–8 NiMH cells, 2A, 110–240VAC input, Tamiya connector. | [Product page](https://www.carson-modelsport.com/carson_fr/pieces-detachees-accessoires/accessoires-rc/chargeurs/expert-charger-nimh-2a-500606099-fr.html) |
| Onboard computer kit | **Raspberry Pi 4 Model B 4GB; GoTronic KIT-PI4-4 / 38684** | 1 | 159.50 | Includes the official case, 32GB microSD, 5V/3A desktop power supply, heatsinks, and HDMI→micro-HDMI cable. | [Product page](https://www.gotronic.fr/art-kit-raspberry-pi-4-b-kit-pi4-4-38590.htm) |
| Active cooling | **Raspberry Pi 4 Case Fan SC0448** | 1 | 6.50 | Fits the official Pi 4 case; includes a CPU heatsink, which must not be stacked on the kit's CPU heatsink. | [Product page](https://www.gotronic.fr/art-module-ventilateur-sc0448-32950.htm) |
| Computing-system power bank | **Anker Nano PowerBank A1259, 10000mAh, built-in USB-C cable** | 1 | 49.99 | USB-C output supports 5V/3A; the “30W” product name does not imply 6A output at 5V. | [Product page](https://www.anker.com/fr/products/a1259-built-in-cable-powerbank-10000mah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) |
| Low-level controller board | **STMicroelectronics NUCLEO-F446RE** | 1 | 19.02 | Onboard ST-LINK/V2-1; handles motor/servo control, encoder and near-range sensor acquisition, and stopping on communication timeout. | [Product page](https://fr.rs-online.com/web/p/outils-de-developpement-pour-microcontroleurs/9064624) |
| 2D lidar | **SLAMTEC RPLIDAR A1M8; GoTronic 36236** | 1 | 119.80 | For mapping, localization, and horizontal scanning; the listed product includes a USB-UART adapter but no USB data cable. | [Product page](https://www.gotronic.fr/art-capteur-de-distance-rplidar-a1m8-29031.htm) |
| Inertial measurement module | **Adafruit BNO085, Product ID 4754** | 1 | 29.90 | Connects to STM32 over SPI in this proposal; check magnetic interference near the motor after installation. | [Product page](https://www.gotronic.fr/art-module-9-dof-bno085-ada4754-33477.htm) |
| Low-mounted near-range sensor | **Pololu VL53L1X, Product #3415** | 4 | 23.95 | Two low at the front and two low at the rear are recommended; actual angles and detection coverage require verification on the vehicle. | [Product page](https://www.gotronic.fr/art-capteur-de-distance-vl53l1x-3415-28058.htm) |
| I²C multiplexer | **Adafruit TCA9548A, Product ID 2717** | 1 | 9.20 | Connect the four identical ToF sensors to separate channels; do not connect BNO085 downstream of it. | [Product page](https://www.gotronic.fr/art-module-multiplexeur-i2c-ada2717-26051.htm) |
| Speed and direction encoder | **Seeed Grove Optical Rotary Encoder 101020587 / TCUT1600X01** | 1 | 12.20 | Dual optical detection channels; includes a Grove cable but no encoder disc; custom TT-02 mounting parts are required. | [Product page](https://www.gotronic.fr/art-module-encodeur-optique-grove-101020587-28244.htm) |
| STM32 USB data cable | **StarTech.com USB2HABM50CM** | 1 | 4.90 | USB-A → Mini-B, 0.5m; connects to the NUCLEO ST-LINK USB port. | [Product page](https://www.ldlc.com/fiche/PB00265154.html) |
| Lidar USB data cable | **StarTech.com UUSBHAUB50CM** | 1 | 10.90 | USB-A → Micro-B, 0.5m; connects to the adapter supplied with the lidar. | [Product page](https://www.materiel.net/produit/201702280552.html) |
| Mechanical traction-power main switch | **DAIER R13-401-101; SVB/SEATEC 29847** | 1 | 6.95 | Wired directly in series with the traction supply; rated 12VDC/50A, two terminals, 12mm mounting hole. | [Product page](https://www.svb-marine.fr/fr/seatec-interrupteur-a-bascule-en-metal-12-v-50-a.html) |
| PWM level-buffer IC | **Texas Instruments SN74AHCT125N, PDIP-14** | 1 | Price not verified | Powered at 5V, converts two STM32 3.3V PWM signals to 5V; requires soldering, decoupling, and defined enable states. | [Product page](https://www.digikey.fr/en/products/detail/texas-instruments/SN74AHCT125N/375798) |

The subtotal for the priced items above is **779.33 €**. It includes two traction batteries, although only one is installed on the vehicle at a time. It excludes the buffer IC with its unverified price, the remaining components in the table below, manufacturing, and shipping, so it is not the total project budget for the vehicle.

## 2. Takeover, Protection, and Assembly Accessories

I recommend also including the following group in the complete purchasing list. The radio transmitter handles manual driving and takeover; destinations are still selected in the navigation interface on the existing computer.

| Component | Selected model/specification | Quantity | Compatibility notes | Source |
|---|---|---|---|---|
| Transmitter＋receiver | **FlySky FS-GT5＋FS-BS6 set** | 1 set | For manual mapping/debugging and manual takeover; do not purchase a duplicate receiver. The checkout price for France has not been verified. | [Product page](https://www.hf-modellsport.de/en/fs-gt5-6-channel-radio-set-with-1-receiver.html) |
| Manual/automatic control switching board | **Pololu 4-Channel RC Servo Multiplexer (Assembled) #2806** | 1 | Page price: 25.45 € TTC; supplied from an external warehouse. Switches between the transmitter and STM32 PWM signals to the servo/ESC. | [Product page](https://opencircuit.fr/produit/pololu-4-channel-rc-servo-multiplexer) |
| Receiver-to-switching-board cables | **Pololu #780, Servo Extension Cable 12″ Female–Female** | 3 cables | 30cm, 22AWG, female–female; page price: 5.90 € TTC per cable, 17.70 € for three. | [Product page](https://opencircuit.fr/produit/servo-extension-cable-12-inch-female-female) |
| Transmitter batteries | **Duracell Plus AA / LR6, 1.5V alkaline batteries** | 4 cells | Selected for the FS-GT5's use of 4 AA cells; no additional lithium-battery charging system for the transmitter is introduced. | [Product page](https://www.duracell.fr/) |
| Traction fuse holder | **Littelfuse FHAC0002LXN** | 1 used | ATO blade-fuse holder, 30A/32VDC, 12AWG leads; the checked RS page sells a pack of 5 for 37.465 € TTC, so a per-unit price must not be treated as the actual purchase total. | [Product page](https://fr.rs-online.com/web/p/porte-fusibles/3375234) |
| Spare fuse assortment | **Littelfuse 00940202ZP, ATO Fuse Assortment 6pc** | 1 pack | Contains one each of 5/10/15/20/25/30A; the installed rating must be selected from measured motor current and wiring protection requirements, not simply set to 30A. French stock and price have not been verified. | [Product page](https://www.digikey.com/en/products/detail/littelfuse-inc/00940202ZP/3425348) |
| Solderable connection board | **Adafruit Perma-Proto Half-sized Breadboard PCB, Product ID 1609** | 1 | For low-current signals, the buffer IC, and sensor connections; traction-motor current does not pass through this board. The French price has not been verified. | [Product page](https://www.adafruit.com/product/1609) |

## 3. Required General Materials and Custom Parts

These items have no single off-the-shelf model that fits every modified TT-02. Prepare manufacturing drawings and a wiring schedule from the actual layout rather than inventing a “TT-02 navigation mounting kit” part number.

| Item | Work required |
|---|---|
| Electronics mounting platform | Upper plate and supports attaching it to the chassis; secure the Pi case, NUCLEO, lidar, and power bank. Determine plate outline, hole positions, and material thickness from physical measurements; use flat-plate fabrication without depending on 3D printing. |
| Lidar mount | Keep the scanning plane stable and position the body and other equipment to reduce occlusion; determine height from the actual obstacles and mounting layout. |
| Encoder disc, shaft clamp, and sensor bracket | Make these for the actual drivetrain location; the disc pattern must support dual-channel phase detection. Check mechanical clearance, counts per revolution, and transmission ratio. The Seeed module is not a direct-fit TT-02 encoder. |
| Brackets for four ToF sensors | Support low front/rear mounting and angle adjustment; lateral areas that cannot be detected must not be treated as covered. |
| Traction wiring harness | Route battery positive through the fuse and mechanical switch to the ESC; provide wiring, terminals, insulation, and retention compatible with the actual large Tamiya battery connector. Existing evidence does not establish all wire gauges, terminal current ratings, or final lengths. |
| Motor connections | The WP-1060 version specified for purchase has 4.0mm female bullet connectors on its motor outputs; inspect the supplied motor's actual connectors before deciding whether terminals or adapter cables are needed. |
| Low-current wiring harness | STM32 connections to the IMU, ToF multiplexer, encoder, and PWM buffer; 2.54mm male/female headers, sensor cables, and securing connectors. Obtain the actual wire order from the board documentation and final pin-assignment table. |
| Buffer-circuit small parts | PDIP-14 socket, 100nF decoupling capacitor, resistors and wiring required for inputs/enables; define enable and unused-input states in the wiring diagram. Do not leave the bare IC inputs floating. |
| Fastening and insulation supplies | Screws, nuts, washers, standoffs, heat-shrink tubing, cable ties, cable clips, soft foam, and battery straps; determine lengths and quantities from the manufacturing drawings. |
| Test support and room materials | Stable supports that keep the wheels off the ground during debugging, soft test obstacles, and distance markers in the room. Routes are planned in software; no black-line-following sensor or floor navigation line is required. |

## 4. Connection Relationships

The following shows only the relationships between modules. It is not a pinout that can be wired directly.

```text
Existing computer (destination selection, map display)
             │ Network
Anker A1259 → Raspberry Pi 4B
                    ├─ USB → supplied RPLIDAR A1M8 adapter → lidar
                    └─ USB → NUCLEO-F446RE
                                  ├─ SPI → BNO085
                                  ├─ I²C → TCA9548A → four VL53L1X
                                  ├─ two counter inputs ← optical encoder
                                  └─ two PWM outputs → SN74AHCT125N → Pololu #2806
                                                                         ↓
FS-GT5 → FS-BS6 → manual PWM and mode selection ────────────────────────→ #2806
                                                                         ├─ S-U300 steering servo
                                                                         └─ WP-1060 control input

Carson 7.2V NiMH → fuse → mechanical traction-power main switch → WP-1060 → supplied motor
                                                                  └─ BEC → servo, receiver, and #2806 VM supply
```

- The NUCLEO uses its onboard ST-LINK USB port for power, debugging, and virtual serial communication; no additional ST-LINK or USB-UART is purchased. Use [ST's official UM1724](https://www.st.com/resource/en/user_manual/um1724-stm32-nucleo64-boards-mb1136-stmicroelectronics.pdf) for the actual serial interface and jumpers rather than copying the old CoVAPSy pin table.
- Connect the receiver to the #2806 master inputs and the buffered STM32 signals to its slave inputs. Its VM and VS supply domains are separate, and all grounds are connected. The STM32 side connects only signals and common ground; VS is left unconnected. Do not join the positive 5V computing supply to the positive 6V BEC supply. [Pololu official manual](https://www.pololu.com/docs/0J60/all)
- SN74AHCT125N uses a 5V supply. TI specifies a minimum high-level input voltage of 2.0V, allowing it to accept the STM32's 3.3V PWM. The final wiring must still be checked for power-up defaults, enable states, and backfeeding when either supply is off. [TI datasheet](https://www.ti.com/lit/ds/symlink/sn74ahct125.pdf)
- The mechanical main switch opens the traction-battery circuit independently of high-level software. Removing traction power does not mean the vehicle immediately comes to rest, and radio takeover does not mean stopping-distance acceptance has been completed.

## 5. Selection Rationale and Practical Limits

### Chassis and Traction

The standard TT-02 is a shaft-driven four-wheel-drive platform with servo-steered front wheels. It cannot rotate in place like a differential-drive robot; usable steering angle and minimum turning space must be measured in the room. [Official Tamiya 58631 page](https://www.tamiya.com/english/products/58631/index.html)

When the earlier all-new purchasing proposal was checked, the official 58631 information stated only that a Type540 motor was included, without giving a separate part number or winding turn count. The JJM product page stated that TBLE-02s was supplied free, while the official basic kit description listed the ESC as sold separately, so WP-1060 was specified in that purchasing reference. This paragraph preserves the rationale used at that time. The user has since confirmed that the actual vehicle uses TBLE-04S; current purchasing actions follow the existing-equipment update above.

The current official WP-1060 specifications are 6–9 NiMH cells and a 6V/3A BEC. With 6 NiMH cells, the motor must also have at least 12T or run below 30000rpm at 7.2V. The supplied motor's markings need checking against these requirements. Its reverse modes have different control sequences, so a negative speed command from the higher-level controller cannot simply be treated as immediate reverse motion. [Hobbywing official product page](https://www.hobbywing.com/en/products/quicrun-wp-1060-brushed55), [official manual](https://www.hobbywing.com/en/uploads/file/20240315/4806bbdbab8eb9fea0bb26da87d81b00.pdf)

The Hobbywing global product page uses identifier 30120200, while the French purchasing page checked here uses VAHW30120201. Both are retained unchanged rather than rewritten as the same identifier. The S-U300 supply voltage matches the BEC, but the public documentation does not provide its stall current; therefore, BEC peak-current margin cannot yet be described as verified on the vehicle. [Futaba official page](https://futabausa.com/product/s-u300-standard-servo/)

The Littelfuse holder's 30A rating is an upper limit, not the fuse rating that should be installed. Fuse selection must account for startup current, normal operating current, and the capabilities of the wiring and connectors; it cannot be inferred from the ESC's advertised 60A. [Littelfuse official fuse-holder datasheet](https://www.littelfuse.com/assetdocs/littelfuse-fuse-holder-ato-fhac-datasheet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)

### Computing Power Supply

This version selects Pi4B 4GB to use an off-the-shelf 5V/3A power bank and reduce onboard power-integration work. The actual navigation computing load still requires testing. The combined limit for all Pi4 USB peripherals is 1.2A, so lidar startup, NUCLEO, and its sensor loads must be checked together; the complete 5V system must also stay within the supply limits. [Raspberry Pi official power-supply documentation](https://www.raspberrypi.com/documentation/computers/raspberry-pi.html)

The official A1259 dimensions are 104×52.3×26mm, with a weight of 215g, and it supports 5V/3A output. Its low-load shutdown behavior and actual runtime have not been measured; it is not used as a UPS. The kit's 5V/3A desktop supply can be used at different times to power the Pi or charge A1259. [Anker official specifications](https://service.anker.com/product-description/a085g00000GiZgpAAF)

### Sensing and Feedback

BNO085 uses SPI because Adafruit explicitly documents I²C compatibility issues with some controllers and multiplexers. The fact that sensors have I²C interfaces does not mean they can all be connected downstream of TCA9548A. [Adafruit official documentation](https://learn.adafruit.com/adafruit-9-dof-orientation-imu-fusion-breakout-bno085?view=all)

The four VL53L1X sensors add low-mounted, near-range observations. They do not replace the lidar or guarantee detection of every low, transparent, or lateral obstacle. Detection distance and angle must be evaluated against the actual objects. [Pololu #3415 official specifications](https://www.pololu.com/product/3415)

The optical encoder provides speed and direction feedback; ESC control pulse width cannot stand in for actual speed. After installation, calibrate counts per revolution, transmission ratio, effective tire circumference, and forward/reverse direction. Steering commands must also be calibrated against measured wheel angles. This version does not add a separate steering-angle sensor, and a servo command is not treated as a measured wheel angle. [Seeed official encoder page](https://www.seeedstudio.com/Grove-Optical-Rotary-Encoder-TCUT1600X01.html)

## 6. Included Items and Equipment That Can Be Borrowed

The Pi kit already includes a 32GB microSD, case, desktop power supply, and display cable. The RPLIDAR product includes a USB-UART adapter, and NUCLEO includes its debugger. The chassis kit includes four wheels and the drivetrain. These items do not need duplicate purchases.

The operator uses an existing computer. The first version adds no camera, GPS/UWB, onboard touchscreen, differential-drive motor driver board, or 3D printer; none is required by the currently confirmed requirements.

The laboratory needs an available multimeter, oscilloscope or logic analyzer, current-limited DC supply, soldering tools, and mechanical measurement/fabrication tools. Availability is not yet confirmed, and a complete set of laboratory instruments has not been imposed on the onboard hardware budget. If basic tools need to be purchased, the models checked during this review include [UNI-T UT139C](https://meters.uni-trend.com/product/ut139-series) and [Weller WE1010 230V](https://www.weller-tools.com/sites/default/files/products/documents/WE_TECH-DATA_T0053298392_WE1010BE_EN.pdf).

## 7. Records Still Required Before Purchasing

1. The packing list, motor nameplate, and motor-terminal photographs for the existing or delivered 58631 equipment; do not purchase the chassis again if it has already been bought.
2. The room's floor-plan dimensions, narrowest passage, floor type, and smallest obstacle to detect, to establish the TT-02's turning space and sensor layout.
3. Actual equipment mounting dimensions, total weight, encoder mechanical drawings, and the complete wiring schedule.
4. Traction startup/operating current, maximum steering load, and the complete USB supply current; then select the fuse rating and test shutdown, radio loss, timeout, and restart behavior.

These records turn a list of models into a vehicle that can be wired, assembled, and evaluated against acceptance criteria. Measurements that have not been completed are not recorded as passed.
