mzy410104-lgtm/auto_car/firmware/auto_car/Core/Src/main.c

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
/* Includes ------------------------------------------------------------------*/
#include "main.h"

/* USER CODE BEGIN Includes */
#include "stdio.h"
/* USER CODE END Includes */

/* USER CODE BEGIN PD */
#define ESC_STOP_PULSE_US       1500U
#define BENCH_TIMEOUT_MS        2000U

#define BNO055_I2C_ADDRESS_7BIT  0x28U
#define BNO055_CHIP_ID_REGISTER  0x00U

#define BMP280_I2C_ADDRESS_7BIT  0x76U
#define BMP280_CHIP_ID_REGISTER  0xD0U

#define BNO055_OPR_MODE_REGISTER  0x3DU
#define BNO055_CONFIG_MODE        0x00U
#define BNO055_NDOF_MODE          0x0CU

#define BNO055_EULER_DATA_REGISTER  0x1AU
#define BNO055_EULER_SCALE           16L
#define IMU_OUTPUT_PERIOD_MS         200U

#define BNO055_CALIB_STAT_REGISTER  0x35U
#define CALIB_OUTPUT_PERIOD_MS      1000U

#define BNO055_SYS_STATUS_REGISTER  0x39U
#define BNO055_SYS_ERR_REGISTER     0x3AU
/* USER CODE END PD */

I2C_HandleTypeDef hi2c1;

TIM_HandleTypeDef htim3;
TIM_HandleTypeDef htim4;

UART_HandleTypeDef huart2;

/* USER CODE BEGIN PV */

static const uint8_t pong_message[] = "PONG\n";

static uint8_t uart_rx_byte = 0U;
static uint8_t uart_line_buffer[16];
static volatile uint8_t uart_line_length = 0U;
static volatile uint8_t uart_line_ready = 0U;
static uint32_t last_led_tick = 0U;

static volatile uint8_t stop_requested = 0U;
static uint8_t bench_command_active = 0U;
static uint32_t last_bench_command_tick = 0U;

static uint32_t last_imu_tick = 0U;

static uint32_t last_calib_tick = 0U;

/* USER CODE END PV */

void SystemClock_Config(void);
static void MX_GPIO_Init(void);
static void MX_USART2_UART_Init(void);
static void MX_TIM3_Init(void);
static void MX_TIM4_Init(void);
static void MX_I2C1_Init(void);
/* USER CODE BEGIN PFP */
static void I2C_Scan(void);
static void Sensor_ReadChipIds(void);
static void BNO055_EnableNDOF(void);
static void BNO055_PrintEuler(void);
static void BNO055_PrintCalibration(void);
static void BNO055_PrintDiagnostics(void);
/* USER CODE END PFP */

/* USER CODE BEGIN 0 */
static void BNO055_PrintDiagnostics(void)
{
    static const uint8_t read_error[] =
        "BNO055 DIAGNOSTIC READ ERROR\r\n";

    uint8_t system_data[2];
    uint8_t operation_mode = 0U;
    char message[80];
    int message_length;

    if (HAL_I2C_Mem_Read(
            &hi2c1,
            (uint16_t)(BNO055_I2C_ADDRESS_7BIT << 1U),
            BNO055_SYS_STATUS_REGISTER,
            I2C_MEMADD_SIZE_8BIT,
            system_data,
            2U,
            100U) != HAL_OK)
    {
        (void)HAL_UART_Transmit(
            &huart2,
            (uint8_t *)read_error,
            (uint16_t)(sizeof(read_error) - 1U),
            100U);
        return;
    }

    if (HAL_I2C_Mem_Read(
            &hi2c1,
            (uint16_t)(BNO055_I2C_ADDRESS_7BIT << 1U),
            BNO055_OPR_MODE_REGISTER,
            I2C_MEMADD_SIZE_8BIT,
            &operation_mode,
            1U,
            100U) != HAL_OK)
    {
        (void)HAL_UART_Transmit(
            &huart2,
            (uint8_t *)read_error,
            (uint16_t)(sizeof(read_error) - 1U),
            100U);
        return;
    }

    message_length = snprintf(
        message,
        sizeof(message),
        "MODE=0x%02X SYS_STATUS=%u SYS_ERR=0x%02X\r\n",
        (unsigned int)operation_mode,
        (unsigned int)system_data[0],
        (unsigned int)system_data[1]);

    if ((message_length > 0) &&
        (message_length < (int)sizeof(message)))
    {
        (void)HAL_UART_Transmit(
            &huart2,
            (uint8_t *)message,
            (uint16_t)message_length,
            100U);
    }
}

static void I2C_Scan(void)
{
    static const uint8_t hex_digits[] = "0123456789ABCDEF";
    static const uint8_t done_message[] = "I2C SCAN DONE\r\n";
    static const uint8_t none_message[] = "I2C DEVICE NOT FOUND\r\n";

    uint8_t message[] = "I2C 0x00\r\n";
    uint8_t device_found = 0U;
    uint16_t address;

    for (address = 0x08U; address <= 0x77U; address++)
    {
        if (HAL_I2C_IsDeviceReady(
                &hi2c1,
                (uint16_t)(address << 1U),
                2U,
                20U) == HAL_OK)
        {
            device_found = 1U;

            message[6] = hex_digits[(address >> 4U) & 0x0FU];
            message[7] = hex_digits[address & 0x0FU];

            (void)HAL_UART_Transmit(
                &huart2,
                message,
                (uint16_t)(sizeof(message) - 1U),
                100U);
        }
    }

    if (device_found != 0U)
    {
        (void)HAL_UART_Transmit(
            &huart2,
            done_message,
            (uint16_t)(sizeof(done_message) - 1U),
            100U);
    }
    else
    {
        (void)HAL_UART_Transmit(
            &huart2,
            none_message,
            (uint16_t)(sizeof(none_message) - 1U),
            100U);
    }
}

static void Sensor_ReadChipIds(void)
{
    static const uint8_t hex_digits[] = "0123456789ABCDEF";
    static const uint8_t bno_error[] = "BNO055 READ ERROR\r\n";
    static const uint8_t bmp_error[] = "BMP280 READ ERROR\r\n";

    uint8_t bno_message[] = "BNO055 ID: 0x00\r\n";
    uint8_t bmp_message[] = "BMP280 ID: 0x00\r\n";
    uint8_t chip_id = 0U;

    if (HAL_I2C_Mem_Read(
            &hi2c1,
            (uint16_t)(BNO055_I2C_ADDRESS_7BIT << 1U),
            BNO055_CHIP_ID_REGISTER,
            I2C_MEMADD_SIZE_8BIT,
            &chip_id,
            1U,
            100U) == HAL_OK)
    {
        bno_message[13] = hex_digits[(chip_id >> 4U) & 0x0FU];
        bno_message[14] = hex_digits[chip_id & 0x0FU];

        (void)HAL_UART_Transmit(
            &huart2,
            bno_message,
            (uint16_t)(sizeof(bno_message) - 1U),
            100U);
    }
    else
    {
        (void)HAL_UART_Transmit(
            &huart2,
            bno_error,
            (uint16_t)(sizeof(bno_error) - 1U),
            100U);
    }

    chip_id = 0U;

    if (HAL_I2C_Mem_Read(
            &hi2c1,
            (uint16_t)(BMP280_I2C_ADDRESS_7BIT << 1U),
            BMP280_CHIP_ID_REGISTER,
            I2C_MEMADD_SIZE_8BIT,
            &chip_id,
            1U,
            100U) == HAL_OK)
    {
        bmp_message[13] = hex_digits[(chip_id >> 4U) & 0x0FU];
        bmp_message[14] = hex_digits[chip_id & 0x0FU];

        (void)HAL_UART_Transmit(
            &huart2,
            bmp_message,
            (uint16_t)(sizeof(bmp_message) - 1U),
            100U);
    }
    else
    {
        (void)HAL_UART_Transmit(
            &huart2,
            bmp_error,
            (uint16_t)(sizeof(bmp_error) - 1U),
            100U);
    }
}

static void BNO055_EnableNDOF(void)
{
    static const uint8_t hex_digits[] = "0123456789ABCDEF";
    static const uint8_t write_error[] = "BNO055 MODE WRITE ERROR\r\n";
    static const uint8_t read_error[] = "BNO055 MODE READ ERROR\r\n";

    uint8_t message[] = "BNO055 MODE: 0x00\r\n";
    uint8_t mode = BNO055_CONFIG_MODE;

    if (HAL_I2C_Mem_Write(
            &hi2c1,
            (uint16_t)(BNO055_I2C_ADDRESS_7BIT << 1U),
            BNO055_OPR_MODE_REGISTER,
            I2C_MEMADD_SIZE_8BIT,
            &mode,
            1U,
            100U) != HAL_OK)
    {
        (void)HAL_UART_Transmit(
            &huart2,
            write_error,
            (uint16_t)(sizeof(write_error) - 1U),
            100U);
        return;
    }

    HAL_Delay(20U);

    mode = BNO055_NDOF_MODE;

    if (HAL_I2C_Mem_Write(
            &hi2c1,
            (uint16_t)(BNO055_I2C_ADDRESS_7BIT << 1U),
            BNO055_OPR_MODE_REGISTER,
            I2C_MEMADD_SIZE_8BIT,
            &mode,
            1U,
            100U) != HAL_OK)
    {
        (void)HAL_UART_Transmit(
            &huart2,
            write_error,
            (uint16_t)(sizeof(write_error) - 1U),
            100U);
        return;
    }

    HAL_Delay(10U);

    mode = 0U;

    if (HAL_I2C_Mem_Read(
            &hi2c1,
            (uint16_t)(BNO055_I2C_ADDRESS_7BIT << 1U),
            BNO055_OPR_MODE_REGISTER,
            I2C_MEMADD_SIZE_8BIT,
            &mode,
            1U,
            100U) == HAL_OK)
    {
        message[15] = hex_digits[(mode >> 4U) & 0x0FU];
        message[16] = hex_digits[mode & 0x0FU];

        (void)HAL_UART_Transmit(
            &huart2,
            message,
            (uint16_t)(sizeof(message) - 1U),
            100U);
    }
    else
    {
        (void)HAL_UART_Transmit(
            &huart2,
            read_error,
            (uint16_t)(sizeof(read_error) - 1U),
            100U);
    }
}

static void BNO055_PrintEuler(void)
{
    static const uint8_t read_error[] = "BNO055 EULER READ ERROR\r\n";

    uint8_t data[6];
    int16_t heading_raw;
    int16_t roll_raw;
    int16_t pitch_raw;

    int32_t heading_cdeg;
    int32_t roll_cdeg;
    int32_t pitch_cdeg;

    char message[80];
    int message_length;

    if (HAL_I2C_Mem_Read(
            &hi2c1,
            (uint16_t)(BNO055_I2C_ADDRESS_7BIT << 1U),
            BNO055_EULER_DATA_REGISTER,
            I2C_MEMADD_SIZE_8BIT,
            data,
            6U,
            100U) != HAL_OK)
    {
        (void)HAL_UART_Transmit(
            &huart2,
            (uint8_t *)read_error,
            (uint16_t)(sizeof(read_error) - 1U),
            100U);
        return;
    }

    heading_raw = (int16_t)(
        ((uint16_t)data[1] << 8U) |
        (uint16_t)data[0]);

    roll_raw = (int16_t)(
        ((uint16_t)data[3] << 8U) |
        (uint16_t)data[2]);

    pitch_raw = (int16_t)(
        ((uint16_t)data[5] << 8U) |
        (uint16_t)data[4]);

    /*
     * BNO055 produces 16 LSB per degree.
     * Convert to centidegrees:
     * 12345 means 123.45 degrees.
     */
    heading_cdeg =
        ((int32_t)heading_raw * 100L) / BNO055_EULER_SCALE;

    roll_cdeg =
        ((int32_t)roll_raw * 100L) / BNO055_EULER_SCALE;

    pitch_cdeg =
        ((int32_t)pitch_raw * 100L) / BNO055_EULER_SCALE;

    message_length = snprintf(
        message,
        sizeof(message),
        "H_cdeg=%ld R_cdeg=%ld P_cdeg=%ld\r\n",
        (long)heading_cdeg,
        (long)roll_cdeg,
        (long)pitch_cdeg);

    if ((message_length > 0) &&
        (message_length < (int)sizeof(message)))
    {
        (void)HAL_UART_Transmit(
            &huart2,
            (uint8_t *)message,
            (uint16_t)message_length,
            100U);
    }
}

void HAL_GPIO_EXTI_Callback(uint16_t GPIO_Pin)
{
    if (GPIO_Pin == B1_Pin)
    {
        stop_requested = 1U;
    }
}

void HAL_UART_RxCpltCallback(UART_HandleTypeDef *huart)
{
    if (huart->Instance == USART2)
    {
        if (uart_line_ready == 0U)
        {
            if (uart_rx_byte == (uint8_t)'\n')
            {
                uart_line_ready = 1U;
            }
            else if (uart_rx_byte != (uint8_t)'\r')
            {
                if (uart_line_length < (uint8_t)sizeof(uart_line_buffer))
                {
                    uart_line_buffer[uart_line_length] = uart_rx_byte;
                    uart_line_length++;
                }
                else
                {
                    uart_line_length = 0U;
                }
            }
        }

        if (HAL_UART_Receive_IT(&huart2, &uart_rx_byte, 1U) != HAL_OK)
        {
            Error_Handler();
        }
    }
}

static void BNO055_PrintCalibration(void)
{
    static const uint8_t read_error[] =
        "BNO055 CALIB READ ERROR\r\n";

    uint8_t calib_status = 0U;
    uint8_t system_status;
    uint8_t gyro_status;
    uint8_t accel_status;
    uint8_t mag_status;

    char message[64];
    int message_length;

    if (HAL_I2C_Mem_Read(
            &hi2c1,
            (uint16_t)(BNO055_I2C_ADDRESS_7BIT << 1U),
            BNO055_CALIB_STAT_REGISTER,
            I2C_MEMADD_SIZE_8BIT,
            &calib_status,
            1U,
            100U) != HAL_OK)
    {
        (void)HAL_UART_Transmit(
            &huart2,
            (uint8_t *)read_error,
            (uint16_t)(sizeof(read_error) - 1U),
            100U);
        return;
    }

    system_status = (calib_status >> 6U) & 0x03U;
    gyro_status   = (calib_status >> 4U) & 0x03U;
    accel_status  = (calib_status >> 2U) & 0x03U;
    mag_status    = calib_status & 0x03U;

    message_length = snprintf(
        message,
        sizeof(message),
        "CAL SYS=%u GYR=%u ACC=%u MAG=%u\r\n",
        (unsigned int)system_status,
        (unsigned int)gyro_status,
        (unsigned int)accel_status,
        (unsigned int)mag_status);

    if ((message_length > 0) &&
        (message_length < (int)sizeof(message)))
    {
        (void)HAL_UART_Transmit(
            &huart2,
            (uint8_t *)message,
            (uint16_t)message_length,
            100U);
    }
}
/* USER CODE END 0 */

/**
  * @brief  The application entry point.
  * @retval int
  */
int main(void)
{

  /* MCU Configuration--------------------------------------------------------*/

  /* Reset of all peripherals, Initializes the Flash interface and the Systick. */
  HAL_Init();

  /* Configure the system clock */
  SystemClock_Config();

  /* Initialize all configured peripherals */
  MX_GPIO_Init();
  MX_USART2_UART_Init();
  MX_TIM3_Init();
  MX_TIM4_Init();
  MX_I2C1_Init();
  /* USER CODE BEGIN 2 */
	if (HAL_UART_Receive_IT(&huart2, &uart_rx_byte, 1U) != HAL_OK)
	{
    Error_Handler();
	}
	if (HAL_TIM_PWM_Start(&htim3, TIM_CHANNEL_2) != HAL_OK)
	{
    Error_Handler();
	}

	HAL_Delay(700);
	I2C_Scan();
	Sensor_ReadChipIds();
	BNO055_EnableNDOF();


	if (HAL_TIM_PWM_Start(&htim4, TIM_CHANNEL_1) != HAL_OK)
	{
    Error_Handler();
	}
  __HAL_TIM_SET_COMPARE(
    &htim4,
    TIM_CHANNEL_1,
    ESC_STOP_PULSE_US
  );
  /* USER CODE END 2 */

  /* Infinite loop */
  /* USER CODE BEGIN WHILE */
	while (1)
	{
    /* USER CODE END WHILE */

    /* USER CODE BEGIN 3 */
		if (stop_requested != 0U)
		{
			__HAL_TIM_SET_COMPARE(
					&htim4,
					TIM_CHANNEL_1,
					ESC_STOP_PULSE_US
			);

			bench_command_active = 0U;
			stop_requested = 0U;
		}
		else if ((bench_command_active != 0U) &&
         ((HAL_GetTick() - last_bench_command_tick) >= BENCH_TIMEOUT_MS))
		{
			__HAL_TIM_SET_COMPARE(
					&htim4,
					TIM_CHANNEL_1,
					ESC_STOP_PULSE_US
			);

			bench_command_active = 0U;
		}

		if ((HAL_GetTick() - last_led_tick) >= 500U)
		{
			last_led_tick = HAL_GetTick();
			HAL_GPIO_TogglePin(LD2_GPIO_Port, LD2_Pin);
		}
		if ((HAL_GetTick() - last_imu_tick) >= IMU_OUTPUT_PERIOD_MS)
		{
			last_imu_tick = HAL_GetTick();
			BNO055_PrintEuler();
		}

		if ((HAL_GetTick() - last_calib_tick) >= CALIB_OUTPUT_PERIOD_MS)
		{
			last_calib_tick = HAL_GetTick();
			BNO055_PrintCalibration();
			BNO055_PrintDiagnostics();
		}

		if (uart_line_ready != 0U)
		{
			if ((uart_line_length == 4U) &&
					(uart_line_buffer[0] == (uint8_t)'P') &&
					(uart_line_buffer[1] == (uint8_t)'I') &&
					(uart_line_buffer[2] == (uint8_t)'N') &&
					(uart_line_buffer[3] == (uint8_t)'G'))
			{
					HAL_UART_Transmit(
							&huart2,
							(uint8_t *)pong_message,
							(uint16_t)(sizeof(pong_message) - 1U),
							100U
					);
			}

			uart_line_length = 0U;
			uart_line_ready = 0U;
		}
  }
  /* USER CODE END 3 */
}

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
