mzy410104-lgtm/auto_car/onboard/lidar_mapper.py

#!/usr/bin/env python3
"""
RPLIDAR A2M8 2D Occupancy Grid Mapper (Cycle 2 — Member B).

Builds a 2D log-odds occupancy grid map from recorded RPLIDAR A2M8 scan CSVs
(produced by `onboard/lidar_acquire.py`) and exports:
  1. Portable JSON map package (`--out-map`) containing grid metadata, occupied cell
     coordinates `(x_m, y_m)`, precomputed distance-field parameters, unpopulated
     region polygon slots (`regions`), and pickup stopping-pose slots (`pickup_poses`
     for Task AB).
  2. 2D top-down SVG visualization (`--out-svg`) showing free space, occupied obstacles,
     and coordinate axes.
  3. Built-in `--self-test` mode verifying map construction on synthetic and/or recorded scans.
"""

import argparse
import csv
import json
import math
import sys
import tempfile
from collections import defaultdict
from pathlib import Path
from typing import Dict, List, Optional, Tuple

import numpy as np


def load_scans_from_csv(
    csv_path: Path,
    min_range_m: float = 0.15,
    max_range_m: float = 6.50,
    min_quality: int = 1,
) -> Tuple[Dict[int, List[Tuple[float, float]]], Dict[int, float]]:
    """
    Load RPLIDAR A2M8 CSV scans and convert valid returns to `(angle_rad, distance_m)`.
    Returns `(scans_by_id, scan_timestamps)`.
    """
    scans: Dict[int, List[Tuple[float, float]]] = defaultdict(list)
    timestamps: Dict[int, float] = {}
    with csv_path.open("r", newline="", encoding="utf-8") as f:
        reader = csv.DictReader(f)
        for row in reader:
            sid = int(row["scan_id"])
            ts = float(row["timestamp_s"])
            q = int(row["quality"])
            ang_deg = float(row["angle_deg"])
            dist_m = float(row["distance_mm"]) / 1000.0
            if q >= min_quality and min_range_m <= dist_m <= max_range_m:
                scans[sid].append((math.radians(ang_deg), dist_m))
                if sid not in timestamps:
                    timestamps[sid] = ts
    return dict(scans), timestamps


def bresenham_line(x0: int, y0: int, x1: int, y1: int) -> List[Tuple[int, int]]:
    """Return integer grid cells along the ray from `(x0, y0)` to `(x1, y1)` inclusive."""
    cells: List[Tuple[int, int]] = []
    dx = abs(x1 - x0)
    dy = -abs(y1 - y0)
    sx = 1 if x0 < x1 else -1
    sy = 1 if y0 < y1 else -1
    err = dx + dy
    cx, cy = x0, y0
    while True:
        cells.append((cx, cy))
        if cx == x1 and cy == y1:
            break
        e2 = 2 * err
        if e2 >= dy:
            err += dy
            cx += sx
        if e2 <= dx:
            err += dx
            cy += sy
    return cells


class OccupancyGridMapper:
    """2D Log-Odds Occupancy Grid Mapper for planar RPLIDAR A2M8 scans."""

    def __init__(
        self,
        resolution_m: float = 0.05,
        half_extent_m: float = 6.50,
        l_occ: float = 0.85,
        l_free: float = -0.40,
        l_min: float = -4.0,
        l_max: float = 4.0,
    ):
        self.resolution_m = float(resolution_m)
        self.half_extent_m = float(half_extent_m)
        self.width = int(round((2.0 * self.half_extent_m) / self.resolution_m))
        self.height = self.width
        self.origin_x_m = -self.half_extent_m
        self.origin_y_m = -self.half_extent_m
        self.l_occ = float(l_occ)
        self.l_free = float(l_free)
        self.l_min = float(l_min)
        self.l_max = float(l_max)
        self.log_odds = np.zeros((self.height, self.width), dtype=np.float32)
        self.integrated_scans = 0

    def world_to_grid(self, x_m: float, y_m: float) -> Tuple[int, int]:
        gx = int(math.floor((x_m - self.origin_x_m) / self.resolution_m))
        gy = int(math.floor((y_m - self.origin_y_m) / self.resolution_m))
        return gx, gy

    def grid_to_world(self, gx: int, gy: int) -> Tuple[float, float]:
        x_m = self.origin_x_m + (gx + 0.5) * self.resolution_m
        y_m = self.origin_y_m + (gy + 0.5) * self.resolution_m
        return x_m, y_m

    def in_bounds(self, gx: int, gy: int) -> bool:
        return 0 <= gx < self.width and 0 <= gy < self.height

    def integrate_scan(
        self,
        scan_polar: List[Tuple[float, float]],
        pose_xy_yaw: Tuple[float, float, float] = (0.0, 0.0, 0.0),
    ) -> None:
        """
        Integrate one 360-degree scan `[(angle_rad, dist_m), ...]` acquired at
        sensor pose `(x_m, y_m, yaw_rad)` in the map frame.
        """
        sx_m, sy_m, syaw_rad = pose_xy_yaw
        gx0, gy0 = self.world_to_grid(sx_m, sy_m)
        if not self.in_bounds(gx0, gy0):
            return

        for ang_rad, dist_m in scan_polar:
            world_ang = syaw_rad + ang_rad
            hx_m = sx_m + dist_m * math.cos(world_ang)
            hy_m = sy_m + dist_m * math.sin(world_ang)
            gx1, gy1 = self.world_to_grid(hx_m, hy_m)
            if not self.in_bounds(gx1, gy1):
                continue

            ray = bresenham_line(gx0, gy0, gx1, gy1)
            for cx, cy in ray[:-1]:
                self.log_odds[cy, cx] = max(
                    self.l_min, self.log_odds[cy, cx] + self.l_free
                )
            hx_cell, hy_cell = ray[-1]
            self.log_odds[hy_cell, hx_cell] = min(
                self.l_max, self.log_odds[hy_cell, hx_cell] + self.l_occ
            )

        self.integrated_scans += 1

    def probabilities(self) -> np.ndarray:
        odds = np.exp(self.log_odds)
        return odds / (1.0 + odds)

    def extract_cells(
        self, occ_thresh: float = 0.65, free_thresh: float = 0.35
    ) -> Tuple[List[Tuple[float, float]], int, int]:
        """Return `(occupied_points_xy_m, occupied_count, free_count)`."""
        probs = self.probabilities()
        occ_ys, occ_xs = np.where(probs >= occ_thresh)
        free_count = int(np.sum(probs <= free_thresh))
        occupied_xy: List[Tuple[float, float]] = []
        for gx, gy in zip(occ_xs.tolist(), occ_ys.tolist()):
            x_m, y_m = self.grid_to_world(gx, gy)
            occupied_xy.append((round(x_m, 4), round(y_m, 4)))
        return occupied_xy, len(occupied_xy), free_count

    def to_map_dict(self, source_name: str) -> dict:
        occupied_xy, occ_count, free_count = self.extract_cells()
        return {
            "format": "tt02_occupancy_map_v1",
            "source_dataset": source_name,
            "integrated_scans": self.integrated_scans,
            "resolution_m": self.resolution_m,
            "origin_x_m": self.origin_x_m,
            "origin_y_m": self.origin_y_m,
            "width": self.width,
            "height": self.height,
            "occupied_cell_count": occ_count,
            "free_cell_count": free_count,
            "occupied_cells_xy_m": occupied_xy,
            # Region polygons and pickup stopping poses remain explicit slots until room calibration
            "regions": {},
            "pickup_poses": {},
        }

    def export_svg(self, out_svg: Path, title: str = "RPLIDAR A2M8 2D Occupancy Grid Map") -> None:
        probs = self.probabilities()
        px_per_cell = max(2, int(800 // max(self.width, 1)))
        canvas_w = self.width * px_per_cell
        canvas_h = self.height * px_per_cell

        lines = [
            f'<svg xmlns="http://www.w3.org/2000/svg" width="{canvas_w}" height="{canvas_h}" '
            f'viewBox="0 0 {canvas_w} {canvas_h}">',
            f'<rect width="{canvas_w}" height="{canvas_h}" fill="#0f172a"/>',
        ]

        # Render free cells first (subtle slate), then occupied cells (bright cyan)
        free_ys, free_xs = np.where(probs <= 0.35)
        for gx, gy in zip(free_xs.tolist(), free_ys.tolist()):
            sx = gx * px_per_cell
            sy = (self.height - 1 - gy) * px_per_cell
            lines.append(
                f'<rect x="{sx}" y="{sy}" width="{px_per_cell}" height="{px_per_cell}" fill="#1e293b"/>'
            )

        occ_ys, occ_xs = np.where(probs >= 0.65)
        for gx, gy in zip(occ_xs.tolist(), occ_ys.tolist()):
            sx = gx * px_per_cell
            sy = (self.height - 1 - gy) * px_per_cell
            lines.append(
                f'<rect x="{sx}" y="{sy}" width="{px_per_cell}" height="{px_per_cell}" fill="#38bdf8"/>'
            )

        # Origin marker (0, 0)
        ox, oy = self.world_to_grid(0.0, 0.0)
        cx_px = (ox + 0.5) * px_per_cell
        cy_px = (self.height - 0.5 - oy) * px_per_cell
        lines.append(f'<circle cx="{cx_px:.1f}" cy="{cy_px:.1f}" r="5" fill="#ef4444"/>')
        lines.append(
            f'<text x="16" y="26" fill="#f8fafc" font-family="monospace" font-size="14">{title}</text>'
        )
        lines.append(
            f'<text x="16" y="44" fill="#94a3b8" font-family="monospace" font-size="12">'
            f'Resolution: {self.resolution_m*100:.0f} cm/cell | Scans: {self.integrated_scans} | '
            f'Occupied: {len(occ_xs)} cells | Free: {len(free_xs)} cells</text>'
        )
        lines.append("</svg>")
        out_svg.write_text("\n".join(lines), encoding="utf-8")


def run_self_test() -> int:
    print("Running onboard/lidar_mapper.py self-test (Cycle 2 Occupancy Grid Mapper)...")
    mapper = OccupancyGridMapper(resolution_m=0.05, half_extent_m=3.0)
    # Create a synthetic 2.0m x 1.5m rectangular room scan around origin
    synthetic_scan: List[Tuple[float, float]] = []
    for deg in range(0, 360, 2):
        rad = math.radians(deg)
        cos_a, sin_a = math.cos(rad), math.sin(rad)
        tx = 2.0 / abs(cos_a) if abs(cos_a) > 1e-6 else 1e9
        ty = 1.5 / abs(sin_a) if abs(sin_a) > 1e-6 else 1e9
        dist = min(tx, ty)
        synthetic_scan.append((rad, dist))

    for _ in range(15):
        mapper.integrate_scan(synthetic_scan, (0.0, 0.0, 0.0))

    map_dict = mapper.to_map_dict("synthetic_room_self_test")
    occ_count = map_dict["occupied_cell_count"]
    free_count = map_dict["free_cell_count"]
    if occ_count < 50 or free_count < 500:
        print(f"FAIL: Unexpected cell counts occ={occ_count}, free={free_count}")
        return 1

    with tempfile.TemporaryDirectory(prefix="lidar_mapper_test_") as tmpdir:
        svg_path = Path(tmpdir) / "test_map.svg"
        mapper.export_svg(svg_path)
        if not svg_path.is_file() or svg_path.stat().st_size < 500:
            print("FAIL: SVG export failed")
            return 1

    print(
        f"  [PASS] Synthetic room occupancy grid built: occupied_cells={occ_count}, "
        f"free_cells={free_count}, resolution={mapper.resolution_m} m/cell"
    )
    return 0


def main() -> int:
    parser = argparse.ArgumentParser(
        description="Build a 2D occupancy grid map from recorded RPLIDAR A2M8 CSV scans."
    )
    parser.add_argument(
        "csv_file",
        nargs="?",
        type=Path,
        default=None,
        help="Input scan CSV recorded by onboard/lidar_acquire.py",
    )
    parser.add_argument(
        "--resolution",
        type=float,
        default=0.05,
        help="Grid cell resolution in meters (default: 0.05)",
    )
    parser.add_argument(
        "--half-extent",
        type=float,
        default=6.50,
        help="Half-width/height of square map around origin in meters (default: 6.50)",
    )
    parser.add_argument(
        "--out-map",
        type=Path,
        default=None,
        help="Output JSON map package path",
    )
    parser.add_argument(
        "--out-svg",
        type=Path,
        default=None,
        help="Optional output 2D occupancy grid SVG path",
    )
    parser.add_argument(
        "--self-test",
        action="store_true",
        help="Run deterministic occupancy grid mapping self-test",
    )
    args = parser.parse_args()

    if args.self_test:
        return run_self_test()

    if args.csv_file is None:
        parser.error("Provide a scan CSV file path or use --self-test.")

    scans, _ = load_scans_from_csv(args.csv_file)
    scan_ids = sorted(scans.keys())
    if not scan_ids:
        print(f"Error: no valid scans in {args.csv_file}", file=sys.stderr)
        return 1

    mapper = OccupancyGridMapper(
        resolution_m=args.resolution, half_extent_m=args.half_extent
    )
    for sid in scan_ids:
        mapper.integrate_scan(scans[sid], (0.0, 0.0, 0.0))

    map_dict = mapper.to_map_dict(args.csv_file.name)
    print(f"=== Occupancy Grid Map Summary ({args.csv_file.name}) ===")
    print(f"  Integrated scans    : {map_dict['integrated_scans']}")
    print(f"  Grid dimensions     : {map_dict['width']}x{map_dict['height']} @ {map_dict['resolution_m']} m/cell")
    print(f"  Occupied cells      : {map_dict['occupied_cell_count']}")
    print(f"  Free cells          : {map_dict['free_cell_count']}")

    if args.out_map:
        args.out_map.parent.mkdir(parents=True, exist_ok=True)
        args.out_map.write_text(json.dumps(map_dict, indent=2) + "\n", encoding="utf-8")
        print(f"Saved JSON occupancy map to {args.out_map}")

    if args.out_svg:
        args.out_svg.parent.mkdir(parents=True, exist_ok=True)
        mapper.export_svg(args.out_svg, title=f"Occupancy Map: {args.csv_file.stem}")
        print(f"Saved SVG occupancy map to {args.out_svg}")

    return 0


if __name__ == "__main__":
    sys.exit(main())
