mzy410104-lgtm/auto_car/(commit log)

2026-09-08 Translate project documentation and collaboration materials into English
2026-09-08 Assign STM32 ownership and plan the first firmware project
2026-09-22 Add STM32 UART communication baseline
2026-09-22 Enable USART2 interrupt reception
2026-09-22 Record STM32 USART2 interrupt test
2026-09-22 Record verified STM32 serial interface
2026-09-22 Add STM32 PING PONG diagnostic protocol
2026-09-22 Replace task board with Cycle 1 issues
2026-09-24 Add C3 SEN0253 acquisition and safe actuator baseline
2026-11-03 Add Raspberry Pi RPLIDAR A2M8 acquisition/replay tools and Pi-STM32 serial test records
    - Add RPLIDAR A2M8 scan acquisition, motor PWM control, replay SVG plotter, and live web viewer in onboard/
    - Add Raspberry Pi <-> STM32 NUCLEO-F103RB serial diagnostic and USB reconnect test script (onboard/stm32_comm_test.py)
    - Record verified Cycle 1 B3/B5 and BC/C5 hardware test evidence in tests/records/
    - Update onboard/README.md and interfaces/CONTROL_INTERFACE.md with verified hardware parameters
2026-11-04 Add OV5647 camera web streamer, dataset manifest validator, and Cycle 1 B1/B2/B4/AB/BC/B6 records
2026-11-04 Add interactive classroom camera AI and LiDAR localization simulator (onboard/classroom_ai_simulator.py)
