mzy410104-lgtm/auto_car/(notices)

Notices in the files:
firmware/auto_car/Core/Src/main.c:
Copyright (c) 2026 STMicroelectronics.
All rights reserved.
This software is licensed under terms that can be found in the LICENSE file
